dineshannayya/riscduino/docs/source/_static/riscduino_layout.png

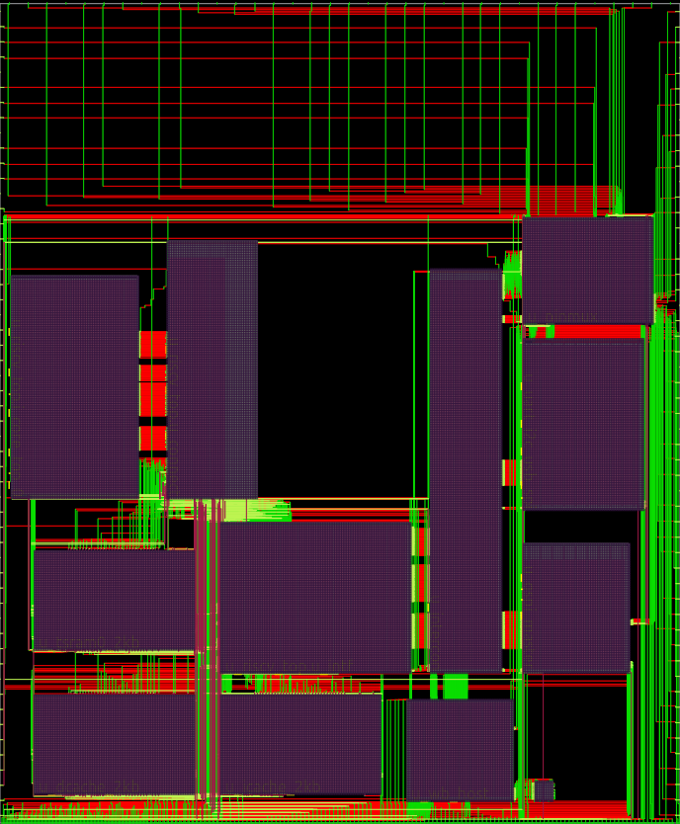
docs/source/_static/riscduino_layout.png
