dineshannayya/riscduino/docs/source/_static/riscduino_placement.png

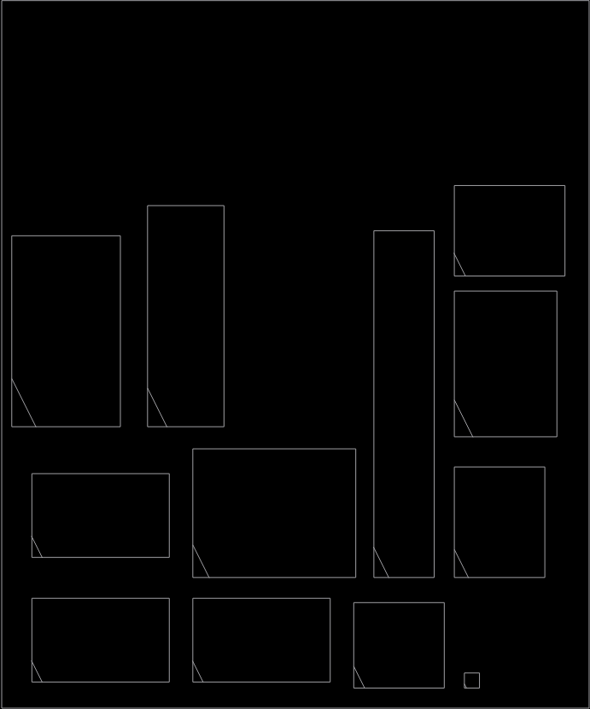
docs/source/_static/riscduino_placement.png
