dineshannayya/riscduino/docs/source/_static/user_project_wrapper.gds.png

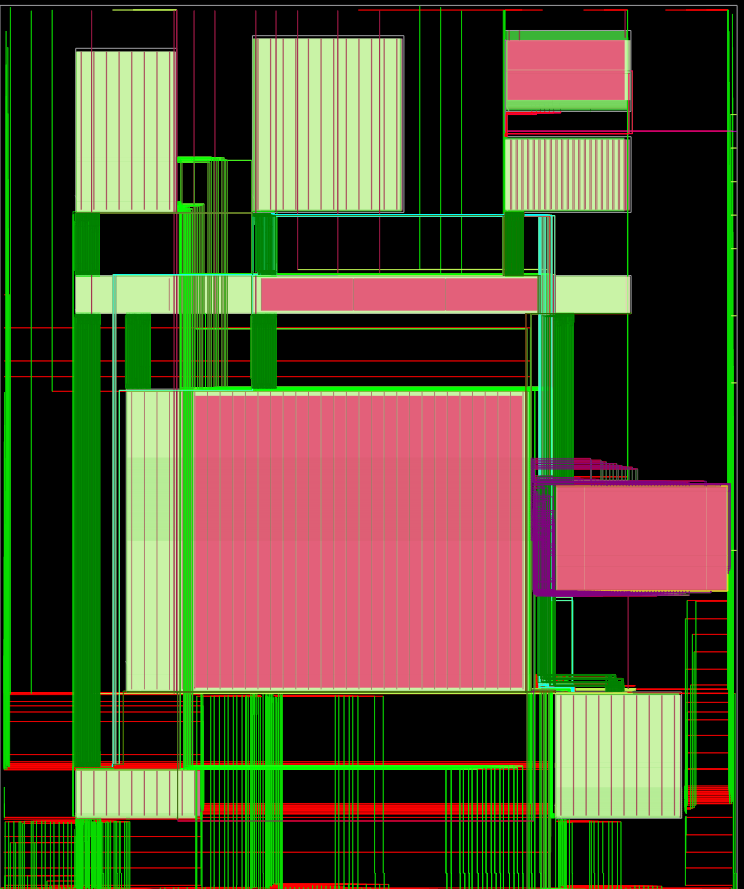
docs/source/_static/user_project_wrapper.gds.png
