dineshannayya/riscduino/signoff/pinmux/final_summary_report.csv

 | design | design_name | config | flow_status | total_runtime | routed_runtime | (Cell/mm^2)/Core_Util | DIEAREA_mm^2 | CellPer_mm^2 | OpenDP_Util | Peak_Memory_Usage_MB | cell_count | tritonRoute_violations | Short_violations | MetSpc_violations | OffGrid_violations | MinHole_violations | Other_violations | Magic_violations | antenna_violations | lvs_total_errors | cvc_total_errors | klayout_violations | wire_length | vias | wns | pl_wns | optimized_wns | fastroute_wns | spef_wns | tns | pl_tns | optimized_tns | fastroute_tns | spef_tns | HPWL | routing_layer1_pct | routing_layer2_pct | routing_layer3_pct | routing_layer4_pct | routing_layer5_pct | routing_layer6_pct | wires_count | wire_bits | public_wires_count | public_wire_bits | memories_count | memory_bits | processes_count | cells_pre_abc | AND | DFF | NAND | NOR | OR | XOR | XNOR | MUX | inputs
0 | /project/openlane/pinmux | pinmux | pinmux | flow completed | 0h17m45s0ms | 0h12m53s0ms | 49486.86868686869 | 0.2475 | 24743.434343434346 | 29.48 | 917.81 | 6124 | 0 | 0 | 0 | 0 | 0 | 0 | 0 | -1 | 0 | -1 | -1 | 483164 | 61636 | -9.79 | -17.46 | -1 | 0.0 | 0.0 | -11345.75 | -19773.69 | -1 | 0.0 | 0.0 | 383662660.0 | 0.0 | 61.73 | 48.44 | 33.8 | 24.46 | -1 | 4054 | 9557 | 810 | 6313 | 0 | 0 | 0 | 4601 | 152 | 83 | 49 | 97 | 1014 | 154 | 18 | 287 | 1210
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
