dineshannayya/riscduino/signoff/qspim_top/final_summary_report.csv

 | design | design_name | config | flow_status | total_runtime | routed_runtime | (Cell/mm^2)/Core_Util | DIEAREA_mm^2 | CellPer_mm^2 | OpenDP_Util | Peak_Memory_Usage_MB | cell_count | tritonRoute_violations | Short_violations | MetSpc_violations | OffGrid_violations | MinHole_violations | Other_violations | Magic_violations | antenna_violations | lvs_total_errors | cvc_total_errors | klayout_violations | wire_length | vias | wns | pl_wns | optimized_wns | fastroute_wns | spef_wns | tns | pl_tns | optimized_tns | fastroute_tns | spef_tns | HPWL | routing_layer1_pct | routing_layer2_pct | routing_layer3_pct | routing_layer4_pct | routing_layer5_pct | routing_layer6_pct | wires_count | wire_bits | public_wires_count | public_wire_bits | memories_count | memory_bits | processes_count | cells_pre_abc | AND | DFF | NAND | NOR | OR | XOR | XNOR | MUX | inputs
0 | /project/openlane/qspim_top | qspim_top | qspim_top | flow completed | 0h19m49s0ms | 0h14m3s0ms | 65696.9696969697 | 0.2475 | 32848.48484848485 | 37.92 | 1031.26 | 8130 | 0 | 0 | 0 | 0 | 0 | 0 | 0 | -1 | 0 | -1 | -1 | 419590 | 71747 | -0.55 | -5.04 | -1 | 0.0 | 0.0 | -21.45 | -1943.78 | -1 | 0.0 | 0.0 | 256460720.0 | 0.0 | 50.47 | 49.05 | 23.05 | 22.36 | -1 | 7374 | 11038 | 803 | 4466 | 0 | 0 | 0 | 8348 | 263 | 96 | 195 | 114 | 1420 | 214 | 34 | 1460 | 1553
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
