dineshannayya/riscduino/signoff/uart_i2cm_usb/final_summary_report.csv

 | design | design_name | config | flow_status | total_runtime | routed_runtime | (Cell/mm^2)/Core_Util | DIEAREA_mm^2 | CellPer_mm^2 | OpenDP_Util | Peak_Memory_Usage_MB | cell_count | tritonRoute_violations | Short_violations | MetSpc_violations | OffGrid_violations | MinHole_violations | Other_violations | Magic_violations | antenna_violations | lvs_total_errors | cvc_total_errors | klayout_violations | wire_length | vias | wns | pl_wns | optimized_wns | fastroute_wns | spef_wns | tns | pl_tns | optimized_tns | fastroute_tns | spef_tns | HPWL | routing_layer1_pct | routing_layer2_pct | routing_layer3_pct | routing_layer4_pct | routing_layer5_pct | routing_layer6_pct | wires_count | wire_bits | public_wires_count | public_wire_bits | memories_count | memory_bits | processes_count | cells_pre_abc | AND | DFF | NAND | NOR | OR | XOR | XNOR | MUX | inputs
0 | /project/openlane/uart_i2cm_usb | uart_i2c_usb_top | uart_i2cm_usb | Flow_completed | 0h25m24s | 0h9m59s | 59157.14285714286 | 0.42 | 29578.57142857143 | 45 | 758.68 | 12423 | 0 | 0 | 0 | 0 | 0 | 0 | 0 | 0 | 0 | -1 | 0 | 522443 | 99881 | -3.16 | -3.16 | -3.07 | -3.07 | -3.11 | -91.08 | -91.08 | -91.67 | -91.67 | -91.56 | 390283627 | 0.0 | 31.24 | 29.46 | 0.31 | -1 | -1 | 12407 | 12476 | 2262 | 2331 | 0 | 0 | 0 | 12423 | 364 | 10 | 202 | 244 | 2118 | 325 | 79 | 2692 | 2224
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
