dineshannayya/riscduino/signoff/spi_master/final_summary_report.csv

 | design | design_name | config | flow_status | total_runtime | routed_runtime | (Cell/mm^2)/Core_Util | DIEAREA_mm^2 | CellPer_mm^2 | OpenDP_Util | Peak_Memory_Usage_MB | cell_count | tritonRoute_violations | Short_violations | MetSpc_violations | OffGrid_violations | MinHole_violations | Other_violations | Magic_violations | antenna_violations | lvs_total_errors | cvc_total_errors | klayout_violations | wire_length | vias | wns | pl_wns | optimized_wns | fastroute_wns | spef_wns | tns | pl_tns | optimized_tns | fastroute_tns | spef_tns | HPWL | routing_layer1_pct | routing_layer2_pct | routing_layer3_pct | routing_layer4_pct | routing_layer5_pct | routing_layer6_pct | wires_count | wire_bits | public_wires_count | public_wire_bits | memories_count | memory_bits | processes_count | cells_pre_abc | AND | DFF | NAND | NOR | OR | XOR | XNOR | MUX | inputs
0 | /project/openlane/spi_master | spim_top | spi_master | Flow_completed | 0h20m39s | 0h10m39s | 58438.46153846153 | 0.26 | 29219.230769230766 | 47 | 664.71 | 7597 | 0 | 0 | 0 | 0 | 0 | 0 | 0 | 0 | 3 | -1 | 0 | 384228 | 67124 | 0.0 | 0.0 | 0.0 | 0.0 | 0.0 | 0.0 | 0.0 | 0.0 | 0.0 | 0.0 | 294776771 | 0.0 | 31.33 | 39.79 | 0.04 | -1 | -1 | 7537 | 7673 | 1268 | 1404 | 0 | 0 | 0 | 7597 | 245 | 0 | 169 | 100 | 1051 | 210 | 32 | 2443 | 1353
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
