dineshannayya/riscduino/(threads)

Thread 4 (2022-02-25):

Openlane implementation error

Sya0, 2022-02-25:
I updated my docker by replacing mpw5 in your docker repo. I got running simulation except spi that fails. However, when I run `make` command in openlane folder or `make user_project_wrapper` in riscdunio root path I got error about some path which I do not have.

```
Error: sta.tcl, 126 can't read "::env(CLOCK_PORT)": no such variable
[ERROR]: during executing: "openroad -exit /openlane/scripts/openroad/resizer.tcl |& tee >&@stdout /project/openlane/clk_skew_adjust/runs/clk_skew_adjust/logs/placement/7-resizer_design_optimization.log"
```

```
Run Directory: /project/openlane/clk_skew_adjust/runs/clk_skew_adjust                                                                                                                                                              
Source not found.

Source: /project/openlane/clk_skew_adjust/runs/clk_skew_adjust/results/lvs/clk_skew_adjust.lvs_parsed.gds.log                                                                                                                      
Source not found.

[INFO]: check full report here: /project/openlane/clk_skew_adjust/runs/clk_skew_adjust/reports/final_summary_report.csv
[INFO]: Saving Runtime Environment
```

There is no path which begins with `project` in my directories. Is there any solution about it ? Thanks for your previous quick replies btw.

dineshannayya, 2022-02-25:
I guess this may be due to openlane docker ..

1.  Can you pull my project openlane docker:    riscduino/openlane:mpw5
> docker pull riscduino/openlane:mpw5

2. set the environmental variable
export IMAGE_NAME=riscduino/openlane:mpw5
export OPENLANE_IMAGE_NAME=riscduino/openlane:mpw5
export OPENLANE_TAG=mpw5

3. Run Make file
>   make user_project_wrapper

Note:  In the latest git version i have moved docker from my name to project name .. i.e now
dineshannayya/dv_setup:mpw5   =>   riscduino/dv_setup:mpw5
dineshannayya/openlane:mpw5   =>   riscduino/openlane:mpw5

I will cross-check if there any specific issue in SPI simulation

dineshannayya, 2022-02-25:
I have cross-check the spi simulation issue, look like one the .hex is not in git repo .. i have update it to git repo ..

You can update the repo .. this should resolve the simulation issue

Sya0, 2022-02-28:
I do not get it. I still get this path error.
`couldn't read file "/home/sukruuzun/caravel_user_project/caravel/openlane/user_project_wrapper_empty/fixed_wrapper_cfgs.tcl": no such file or directory`.

My caravel example project (32 bit counter) openlane synthesis run flawless but this one gives me error about caravel. `fixed_wrapper_cfgs.tcl` script is under `user_project_wrapper`, not `user_project_wrapper_empty`.

dineshannayya, 2022-03-01:
If are using MPW-5 caravel repo .. there is change in fixed_wrapper_cfgs.tcl file location

In MPW-4 :  $::env(CARAVEL_ROOT)/openlane/**user_project_wrapper_empty**/fixed_wrapper_cfgs.tcl
in MPW-5:  $::env(CARAVEL_ROOT)/openlane/**user_project_wrapper**/fixed_wrapper_cfgs.tcl

You need to locally change this file path based on your caravel repo ...

Note: As there is continuous update in caravel repo,  My repo used still uses MPW4 caravel repo.

Sya0, 2022-03-01:
Yes, I use MPW-5 caravel repo. I do not want to make changes in caravel repo. Is there any other way, I made some changes Makefile but it does not work. Should I edit docker image ?

Sya0, 2022-03-01:
I changed them locally, now I have this;
```
FileNotFoundError: [Errno 2] No such file or directory: '/project/openlane/user_project_wrapper/../../lef//qspim.lef'
[ERROR]: during executing: "/openlane/scripts/mergeLef.py -i /project/openlane/user_project_wrapper/runs/user_project_wrapper/tmp/merged_unpadded.lef /project/openlane/user_project_wrapper/../../lef//qspim.lef /project/openlane/user_project_wrapper/../../lef//pinmux.lef /project/openlane/user_project_wrapper/../../lef//wb_interconnect.lef /project/openlane/user_project_wrapper/../../lef//uart_i2cm_usb_spi.lef /project/openlane/user_project_wrapper/../../lef//wb_host.lef /project/openlane/user_project_wrapper/../../lef//yifive.lef /project/openlane/user_project_wrapper/../../lef//DFFRAM.lef -o /project/openlane/user_project_wrapper/runs/user_project_wrapper/tmp/merged_unpadded.lef |& tee >&@stdout"
```

Sorry to bother you but I am new to this, I stuck a lot.

dineshannayya, 2022-03-01:
Default all the lef and gds files are compressed (.gz)  in git repo.

You need to unzip the file in lef and gds folder by using below command
gzip -d *

OR If you using latest repo .. In the use below command in base folder
make unzip

Sya0, 2022-03-01:
I think, I fix the version issue, no more path or version error. However, I have pds error:
```
key "straps" not known in dictionary
[ERROR]: during executing openroad script /openlane/scripts/openroad/pdn.tcl
[ERROR]: Exit code: 1
[ERROR]: Last 10 lines:
child process exited abnormally
```

dineshannayya, 2022-03-01:
Are you using riscduino/openlane:mpw5 OR efabless/openlane  docker ?

I have done PDN hack in Openroad setup to get Power Straps only for vccd1/vssd1. Else in standard Openlane flow does power straps for all the power vccd1/vssd1/vccd2/vssd2/vdda1/vssa1/vdda2/vssa2
This should work with riscduino/openlane:mpw5 docker.

If you want to works with efabless/openlane docker .. Then you can mask below line in user_project_wrapper/Makefile
set ::env(PDN_CFG) $proj_dir/pdn_cfg.tcl

Sya0, 2022-03-01:
Yes, I use efabless/openlane. Is there any possible disadvantage of doing that hack during tape-out?
`Then you can mask below line in user_project_wrapper/Makefile` by meaning that should I comment that line ?

dineshannayya, 2022-03-01:
My Design IP uses only one set of power domain (vccd1/vssd1).  Default openlane flow does power straps for all power domain vccd1/vssd1/vccd2/vssd2/vdda1/vssa1/vdda2/vssa2, even though design need one set of power hook up for hard-macro.
Due to these i need to keep more free space between each hard-macro to get all 8 vertical and horizontal power strip to get connected ..  As my design has less free space between IP.  I have hacked PDN script to excluded un-intended power straps generation, which helps me to keep only 2 vertical and horizontal power strip spacing between hard-ip.

Correction:  You need to comment pdn_cfg.tcl in user_project_wrapper/config.tcl to get openlane flow to working ..
set ::env(PDN_CFG) $proj_dir/pdn_cfg.tcl

If openlane flow PDN connection breaks then you need to move around the macro location to get PDN to pass.

Sya0, 2022-03-01:
I passed lot of checks and synthesis including PDN but now I have this.
```
[ERROR]: during executing: "magic -noconsole -dnull -rcfile /home/sukruuzun/caravel_pdk/sky130A/libs.tech/magic/sky130A.magicrc /openlane/scripts/magic/gds_pointers.tcl </dev/null |& tee >&@stdout /project/openlane/user_project_wrapper/runs/user_project_wrapper/logs/finishing/20-gds_ptrs.log"                                               
[ERROR]: Exit code: 1
[ERROR]: Last 10 lines:
child killed: kill signal
```

dineshannayya, 2022-03-01:
@Sya0 I don't know if this issue related to latest openlane tools. you may need to get help from openlane team.

As you see some of the tool update breaks project .. periodically i check for working openlane docker and clone it to riscdino/openlane

Closed 2022-03-04.

Thread 6 (2022-07-07):

riscduino soc

RanChenRivai, 2022-07-07:
The riscduino is a great project, but after learning about it, I still have some confusion.

Is there a relevant FPGA test routine for the riscduino SOC?
There are some differences between the memory map of riscduino SOC and the memory map of caravel SOC. For example, 0x1000_0000 is QSPI config reg for riscduino and flash spi for caravel, what is the reason for this?

dineshannayya, 2022-07-07:
Q1.: Is there a relevant FPGA test routine for the riscduino SOC?
    Riscduino is currently planned for Efabless MPW 130nm Skywater Free shuttle. Since complete RTL source code is available in the database, any one can port it to FPGA.
 Q2: There are some differences between the memory map of riscduino SOC and the memory map of caravel SOC. For example, 0x1000_0000 is QSPI config reg for riscduino and flash spi for caravel, what is the reason for this?

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

Riscduno has it's own RISC-V processor and it uses QSPI to boot it's processor and has it's own address mapping.
Where as caravel top-level has it's own  RISC-V core which uses SPI to boot and has there own address map.
RISCDUNIO just uses Top-level RISC-V core to just boot the user core and rest of functionality is managed by RISCDUINO core.
Caravel RISC-V core can access the RISCDUNIO core through a indirect address map (As User project address space is allocated is small)

dineshannayya, 2022-07-09:
Closing the issue

Closed 2022-07-09.

Thread 7 (2022-07-08):

MPW-5 single core git version

clp510, 2022-07-08:
How do I get your MPW-5 single core git version?
If i understand correctly, all your MPW code in the same git repo, same branch(master), How do I get different MPW version code? is that possible?

BRs
luping

dineshannayya, 2022-07-08:
Yes, Riscduino has manged through Single Git Repo for all the MPW project.  As there was continuous change in design, I was not clear on which version of the design will be finally picked in the MPW.  To understand the current design version, I have kept two register which indicate the last update and version id inside the pin mux block.  This register will help me to identify version of the chip manufactured.

Due to MPW lottery system , Riscduino-Dcore & Riscduino-QCore are part of MPW-5 shuttle and Riscduino Single core is not part of the MPW-5.
Is any specific reason why you are looking for MPW5 instead of latest version ?

clp510, 2022-07-09:
Thanks for your comments. and thanks for your good project.
Actually I am developing a new riscv core, and I'd like to pick up a stable code base to diverge, to continue the core side develop.
MPW5 is not a *must*, stable is more important for me .
And by the way ,another question is , you say riscduino is pin compatible with Arduino, but Arduino UNO is DIP package format which has only 28 pins, but the open MPW is QFN/WCSP package, It means,  I will draw my own PCB, not buy a arduino UNO , and replace the ATmega328 chip.

dineshannayya, 2022-07-09:
In MPW shuttle has fixed 38 Pin IO with  QFN/WCSP package for user project. I have tried to map 28 Pins as in arduino and rest of the pins are used for External FLASH (As MPW shuttle does have any on-chip FLASH).  You need to make your own PCB and bring the connector as in arudino. If in future if MPW support user defined own package + Internal FLASH, then we can make pin compatible ATMGA chip.
If you planning to branch out, you may need to continuously monitor the changes as currently i am porting ardunio software driver and there will be some design fixes to match the ardunio functionality.

clp510, 2022-07-11:
Thanks to your comments, will follow your advice ~~

dineshannayya, 2022-07-11:
closing the ticket

Closed 2022-07-11.

Thread 8 (2022-07-11):

caravel soc & riscduino soc memory mapping

Yuxiang-Davion, 2022-07-11:
Is the Uart Master in the diagram a new addition to the RISCDUINO core? Seems like it‘s another uart input directly connected to the package pin.
Actually we are planning to build a new project based on the RISCDUINO for open-mpw flow, but we have found that the memory mapping of the caravel soc and the riscduino soc are not the same. What is the basis for this? If we change the memory mapping of riscduino to match the caravel soc, what needs to be changed?

BRs
Yuxiang
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

Yuxiang-Davion, 2022-07-12:
Yeah I see the bug you metioned in caravel SOC... Hope it could be fixed in next mpw project. Thank you for your reply.

Closed 2022-07-12.

Thread 11 (2022-07-22):

openlane/Module call problem

pengpeng-lian, 2022-07-22:
When "make user_project_wrapper",  its config. tcl file does not contain all verilog files,  but only top and its next level. Why can it run all of them?

===================================code==================================
## Source Verilog Files
set ::env(VERILOG_FILES) "\
	$proj_dir/../../verilog/rtl//yifive/ycr1c/src/top/ycr_top_wb.sv \
	$proj_dir/../../verilog/rtl/user_project_wrapper.v"
### Black-box verilog and views

set ::env(VERILOG_FILES_BLACKBOX) "\
        $proj_dir/../../verilog/gl/qspim_top.v \
        $proj_dir/../../verilog/gl/wb_interconnect.v \
        $proj_dir/../../verilog/gl/pinmux.v     \
        $proj_dir/../../verilog/gl/uart_i2c_usb_spi_top.v     \
	$proj_dir/../../verilog/gl/wb_host.v \
	$proj_dir/../../verilog/gl/ycr_intf.v \
	$proj_dir/../../verilog/gl/ycr_core_top.v \
	$proj_dir/../../verilog/gl/ycr_iconnect.v \
	$proj_dir/../../verilog/gl/digital_pll.v \
	$::env(PDK_ROOT)/sky130A/libs.ref/sky130_sram_macros/verilog/sky130_sram_2kbyte_1rw1r_32x512_8.v \
	"
==========================================================================

=================================instruction==================================
make user user_project_wrapper
==========================================================================

pengpeng-lian, 2022-07-22:
Could it be because "set ::env(VERILOG_FILES_BLACKBOX) "\"?   BLACKBOX this parameter?

pengpeng-lian, 2022-07-22:
Could it be because "set ::env(VERILOG_FILES_BLACKBOX) "\"?   BLACKBOX this parameter?

dineshannayya, 2022-07-22:
Each Macro are separately Hardened and Integrated as block box at user_project_wrapper.  If you include all the RTL at user_project_wrapper tool will not be able harden full design in one go.
You need to first run sub macro harden scripts and followed by user_project_wrapper final integration

make pinmux
make uart_i2cm_usb_spi_top
make wb_host  
make ycr_core_top
make ycr_iconnect
make qspim_top
make wb_interconnect
make ycr_intf

make user_project_wrapper

pengpeng-lian, 2022-07-22:
Our team had questions, why separate integrations? Instead of using the total project which contains all the RTL code to integrate at once? Is there a flaw in doing this？

pengpeng-lian, 2022-07-22:
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

 Sorry for the late reply, thank you very much for your answer.
Wouldn't it be more automatic to execute the "make master project" only once?
What is the purpose of this separate integration?

pengpeng-lian, 2022-07-22:
> Current Makefile flow does call automatically all the sub macro. I prefer to run the each macro on need basic to avoid long run time. As most of the time design changes are specific to one macro. For each top-level integration update, you don't need to re-harden all the block.

Thanks for the reply, very useful for me, really appreciate it, solved my problem!

Closed 2022-07-22.

Thread 16 (2022-08-04):

PDN probelm

pengpeng-lian, 2022-08-04:
I have now put all the Verilogs together to run a macro, but have encountered a problem, reporting the following error
#############ERROR###############################
[STEP 6]
[INFO]: Running Tap/Decap Insertion...
[INFO]: Connecting Power: vccd1 & vssd1 to All internal macros.
[INFO]: Generating PDN...
[ERROR]: PDN generation failed.
[ERROR]: You may need to adjust your macro placements or PDN  offsets/pitches to power all standard cell rails (or other PDN stripes)  in your design.
[INFO]: Generating final set of reports...
[INFO]: Created manufacturability report at 'user_project_wrapper/runs/user_project_wrapper/reports/manufacturability.rpt'.
[INFO]: Created metrics report at 'user_project_wrapper/runs/user_project_wrapper/reports/metrics.csv'.
[INFO]: Saving runtime environment...
[ERROR]: Flow failed.

#########################config.tcl###############################################
set ::env(PDK) "sky130A"
set ::env(STD_CELL_LIBRARY) "sky130_fd_sc_hd"

# YOU ARE NOT ALLOWED TO CHANGE ANY VARIABLES DEFINED IN THE FIXED WRAPPER CFGS
source $::env(CARAVEL_ROOT)/openlane/user_project_wrapper/fixed_wrapper_cfgs.tcl

# YOU CAN CHANGE ANY VARIABLES DEFINED IN THE DEFAULT WRAPPER CFGS BY OVERRIDING THEM IN THIS CONFIG.TCL
source $::env(CARAVEL_ROOT)/openlane/user_project_wrapper/default_wrapper_cfgs.tcl

set script_dir [file dirname [file normalize [info script]]]
set proj_dir [file dirname [file normalize [info script]]]

set ::env(ROUTING_CORES) "6"

set ::env(DESIGN_NAME) user_project_wrapper
set verilog_root $proj_dir/../../verilog/

# User Configurations
#
set ::env(DESIGN_IS_CORE) 1
set ::env(FP_PDN_CORE_RING) 1

## Source Verilog Files
set ::env(VERILOG_FILES) "\
	$proj_dir/../../verilog/rtl//yifive/ycr1c/src/top/ycr_top_wb.sv                 \
	$proj_dir/../../verilog/rtl/user_project_wrapper.v                              \
    $script_dir/../../verilog/rtl/clk_skew_adjust/src/clk_skew_adjust.gv \
    $script_dir/../../verilog/rtl/pinmux/src/pinmux.sv     \
    $script_dir/../../verilog/rtl/pinmux/src/pinmux_reg.sv \
    $script_dir/../../verilog/rtl/pinmux/src/gpio_intr.sv  \
    $script_dir/../../verilog/rtl/pinmux/src/pwm.sv        \
    $script_dir/../../verilog/rtl/pinmux/src/timer.sv        \
    $script_dir/../../verilog/rtl/lib/pulse_gen_type1.sv   \
    $script_dir/../../verilog/rtl/lib/pulse_gen_type2.sv   \
    $script_dir/../../verilog/rtl/lib/registers.v          \
    $script_dir/../../verilog/rtl/lib/ctech_cells.sv     \

    $script_dir/../../verilog/rtl/lib/reset_sync.sv      \
    $script_dir/../../verilog/rtl/qspim/src/qspim_top.sv \
    $script_dir/../../verilog/rtl/qspim/src/qspim_if.sv \
    $script_dir/../../verilog/rtl/qspim/src/qspim_regs.sv \
    $script_dir/../../verilog/rtl/qspim/src/qspim_fifo.sv \
    $script_dir/../../verilog/rtl/qspim/src/qspim_clkgen.sv \
    $script_dir/../../verilog/rtl/qspim/src/qspim_ctrl.sv \
    $script_dir/../../verilog/rtl/qspim/src/qspim_rx.sv \
    $script_dir/../../verilog/rtl/qspim/src/qspim_tx.sv	\

    $script_dir/../../verilog/rtl/uart/src/uart_core.sv  \
    $script_dir/../../verilog/rtl/uart/src/uart_cfg.sv   \
    $script_dir/../../verilog/rtl/uart/src/uart_rxfsm.sv \
    $script_dir/../../verilog/rtl/uart/src/uart_txfsm.sv \
    $script_dir/../../verilog/rtl/lib/async_wb.sv   \
    $script_dir/../../verilog/rtl/lib/async_fifo.sv      \
    $script_dir/../../verilog/rtl/lib/async_fifo_th.sv   \
    $script_dir/../../verilog/rtl/lib/double_sync_low.v  \
    $script_dir/../../verilog/rtl/lib/clk_ctl.v          \
    $script_dir/../../verilog/rtl/i2cm/src/core/i2cm_bit_ctrl.v      \
    $script_dir/../../verilog/rtl/i2cm/src/core/i2cm_byte_ctrl.v     \
    $script_dir/../../verilog/rtl/i2cm/src/core/i2cm_top.v           \
    $script_dir/../../verilog/rtl/usb1_host/src/core/usbh_core.sv    \
    $script_dir/../../verilog/rtl/usb1_host/src/core/usbh_crc16.sv   \
    $script_dir/../../verilog/rtl/usb1_host/src/core/usbh_crc5.sv    \
    $script_dir/../../verilog/rtl/usb1_host/src/core/usbh_fifo.sv    \
    $script_dir/../../verilog/rtl/usb1_host/src/core/usbh_sie.sv     \
    $script_dir/../../verilog/rtl/usb1_host/src/phy/usb_fs_phy.v     \
    $script_dir/../../verilog/rtl/usb1_host/src/phy/usb_transceiver.v\
    $script_dir/../../verilog/rtl/usb1_host/src/top/usb1_host.sv     \
    $script_dir/../../verilog/rtl/sspim/src/sspim_top.sv             \
    $script_dir/../../verilog/rtl/sspim/src/sspim_ctl.sv             \
    $script_dir/../../verilog/rtl/sspim/src/sspim_if.sv              \
    $script_dir/../../verilog/rtl/sspim/src/sspim_cfg.sv             \
    $script_dir/../../verilog/rtl/uart_i2c_usb_spi/src/uart_i2c_usb_spi.sv\

    $script_dir/../../verilog/rtl/wb_host/src/wb_host.sv \
    $script_dir/../../verilog/rtl/lib/async_reg_bus.sv   \
    $script_dir/../../verilog/rtl/wb_interconnect/src/wb_arb.sv     \
    $script_dir/../../verilog/rtl/uart2wb/src/uart2wb.sv \
    $script_dir/../../verilog/rtl/uart2wb/src/uart2_core.sv \
    $script_dir/../../verilog/rtl/uart2wb/src/uart_msg_handler.v \

    $script_dir/../../verilog/rtl/lib/sync_wbb.sv                \
    $script_dir/../../verilog/rtl/lib/sync_fifo2.sv                \
    $script_dir/../../verilog/rtl/wb_interconnect/src/wb_slave_port.sv  \
    $script_dir/../../verilog/rtl/wb_interconnect/src/wb_interconnect.sv  \

    $script_dir/../../verilog/rtl/yifive/ycr1c/src/core/pipeline/ycr_pipe_top.sv           \
	$script_dir/../../verilog/rtl/yifive/ycr1c/src/core/ycr_core_top.sv                    \
	$script_dir/../../verilog/rtl/yifive/ycr1c/src/core/ycr_dm.sv                          \
	$script_dir/../../verilog/rtl/yifive/ycr1c/src/core/ycr_tapc_synchronizer.sv           \
	$script_dir/../../verilog/rtl/yifive/ycr1c/src/core/ycr_clk_ctrl.sv                    \
	$script_dir/../../verilog/rtl/yifive/ycr1c/src/core/ycr_scu.sv                         \
	$script_dir/../../verilog/rtl/yifive/ycr1c/src/core/ycr_tapc.sv                        \
	$script_dir/../../verilog/rtl/yifive/ycr1c/src/core/ycr_tapc_shift_reg.sv              \
	$script_dir/../../verilog/rtl/yifive/ycr1c/src/core/ycr_dmi.sv                         \
	$script_dir/../../verilog/rtl/yifive/ycr1c/src/core/primitives/ycr_reset_cells.sv      \
	$script_dir/../../verilog/rtl/yifive/ycr1c/src/core/pipeline/ycr_pipe_ifu.sv           \
	$script_dir/../../verilog/rtl/yifive/ycr1c/src/core/pipeline/ycr_pipe_idu.sv           \
	$script_dir/../../verilog/rtl/yifive/ycr1c/src/core/pipeline/ycr_pipe_exu.sv           \
	$script_dir/../../verilog/rtl/yifive/ycr1c/src/core/pipeline/ycr_pipe_mprf.sv          \
	$script_dir/../../verilog/rtl/yifive/ycr1c/src/core/pipeline/ycr_pipe_csr.sv           \
	$script_dir/../../verilog/rtl/yifive/ycr1c/src/core/pipeline/ycr_pipe_ialu.sv          \
	$script_dir/../../verilog/rtl/yifive/ycr1c/src/core/pipeline/ycr_pipe_mul.sv           \
	$script_dir/../../verilog/rtl/yifive/ycr1c/src/core/pipeline/ycr_pipe_div.sv           \
	$script_dir/../../verilog/rtl/yifive/ycr1c/src/core/pipeline/ycr_pipe_lsu.sv           \
	$script_dir/../../verilog/rtl/yifive/ycr1c/src/core/pipeline/ycr_pipe_hdu.sv           \
	$script_dir/../../verilog/rtl/yifive/ycr1c/src/core/pipeline/ycr_pipe_tdu.sv           \
	$script_dir/../../verilog/rtl/yifive/ycr1c/src/core/pipeline/ycr_ipic.sv               \
        $script_dir/../../verilog/rtl/yifive/ycr1c/src/top/ycr_req_retiming.sv               \

    $script_dir/../../verilog/rtl/yifive/ycr1c/src/top/ycr_iconnect.sv                  \
	$script_dir/../../verilog/rtl/yifive/ycr1c/src/top/ycr_cross_bar.sv                 \
	$script_dir/../../verilog/rtl/yifive/ycr1c/src/top/ycr_router.sv                    \
	$script_dir/../../verilog/rtl/yifive/ycr1c/src/top/ycr_dmem_router.sv                \
	$script_dir/../../verilog/rtl/yifive/ycr1c/src/top/ycr_sram_mux.sv                   \
	$script_dir/../../verilog/rtl/yifive/ycr1c/src/top/ycr_tcm.sv                        \
	$script_dir/../../verilog/rtl/yifive/ycr1c/src/top/ycr_timer.sv                      \
        $script_dir/../../verilog/rtl/yifive/ycr1c/src/lib/ycr_arb.sv                     \

        $script_dir/../../verilog/rtl/yifive/ycr1c/src/cache/src/core/dcache_top.sv            \
        $script_dir/../../verilog/rtl/yifive/ycr1c/src/cache/src/core/dcache_tag_fifo.sv       \
        $script_dir/../../verilog/rtl/yifive/ycr1c/src/cache/src/core/icache_tag_fifo.sv       \
        $script_dir/../../verilog/rtl/yifive/ycr1c/src/cache/src/core/icache_top.sv            \
        $script_dir/../../verilog/rtl/yifive/ycr1c/src/cache/src/core/icache_app_fsm.sv        \
        $script_dir/../../verilog/rtl/yifive/ycr1c/src/lib/ycr_async_wbb.sv                    \
	$script_dir/../../verilog/rtl/yifive/ycr1c/src/top/ycr_dmem_wb.sv                      \
	$script_dir/../../verilog/rtl/yifive/ycr1c/src/top/ycr_intf.sv                        \
    $script_dir/../../verilog/rtl/digital_pll/src/digital_pll_controller.v  \
    $script_dir/../../verilog/rtl/digital_pll/src/digital_pll.v             \
    $script_dir/../../verilog/rtl/digital_pll/src/ring_osc2x13.v    \
    "

### Black-box verilog and views
set ::env(VERILOG_FILES_BLACKBOX) "\
    $::env(PDK_ROOT)/sky130A/libs.ref/sky130_sram_macros/verilog/sky130_sram_2kbyte_1rw1r_32x512_8.v	\
    "

set ::env(EXTRA_LEFS) "\
	$::env(PDK_ROOT)/sky130A/libs.ref/sky130_sram_macros/lef/sky130_sram_2kbyte_1rw1r_32x512_8.lef \
	"
set ::env(EXTRA_GDS_FILES) "\
	$::env(PDK_ROOT)/sky130A/libs.ref/sky130_sram_macros/gds/sky130_sram_2kbyte_1rw1r_32x512_8.gds \
	"

## Clock configurations
set ::env(CLOCK_PORT) "user_clock2 wb_clk_i"
set ::env(CLOCK_PERIOD) "10"

set ::env(SYNTH_MAX_FANOUT) 4

## CTS BUFFER
set ::env(CTS_CLK_BUFFER_LIST) "sky130_fd_sc_hd__clkbuf_4 sky130_fd_sc_hd__clkbuf_8 sky130_fd_sc_hd__clkbuf_16 "
set ::env(CTS_SINK_CLUSTERING_SIZE) "\
    16  \
    50  \
    "
set ::env(CLOCK_BUFFER_FANOUT) "\
    8   \
    20  \
    "
set ::env(LEC_ENABLE) 0

set ::env(VERILOG_INCLUDE_DIRS) "\
    [glob $script_dir/../../verilog/rtl/yifive/ycr1c/src/includes ] \
    [glob $script_dir/../../verilog/rtl/i2cm/src/includes $script_dir/../../verilog/rtl/usb1_host/src/includes ]    \
    [glob $script_dir/../../verilog/rtl/yifive/ycr1c/src/includes ] \
    [glob $script_dir/../../verilog/rtl/yifive/ycr1c/src/includes ] \
    [glob $proj_dir/../../verilog/rtl/yifive/ycr1c/src/includes ]
    "
set ::env(SYNTH_READ_BLACKBOX_LIB) 1
set ::env(SYNTH_DEFINES) [list SYNTHESIS ]

set ::env(SDC_FILE) "\
    $script_dir/base.sdc    \
    $script_dir/pinmux.sdc  \
    $script_dir/qspim.sdc   \
    $script_dir/uart_i2cm_usb_spi_top.sdc   \
    $script_dir/wb_host.sdc \
    $script_dir/wb_interconnect.sdc \
    $script_dir/ycr_core_top.sdc    \
    $script_dir/ycr_iconnect.sdc    \
    $script_dir/ycr_intf.sdc    \
    "
set ::env(BASE_SDC_FILE) "$script_dir/base.sdc"

set ::env(VDD_PIN) [list {vccd1}]
set ::env(GND_PIN) [list {vssd1}]

set ::env(VDD_NETS) {vccd1 vccd2 vdda1 vdda2}
set ::env(GND_NETS) {vssd1 vssd2 vssa1 vssa2}

## Floorplan
set ::env(FP_PIN_ORDER_CFG) $script_dir/pin_order.cfg
set ::env(FP_SZING) absolute

set ::env(MACRO_PLACEMENT_CFG) $script_dir/macro.cfg
set ::env(PL_TARGET_DENSITY) 0.4
set ::env(PDN_CFG) $proj_dir/pdn_cfg.tcl

set ::env(RT_MAX_LAYER) {met5}

set ::env(FP_PDN_CHECK_NODES) 0

set ::env(GLB_RT_MAX_DIODE_INS_ITERS) 10
set ::env(DIODE_INSERTION_STRATEGY) 3

set ::env(QUIT_ON_TIMING_VIOLATIONS) "0"
set ::env(QUIT_ON_MAGIC_DRC) "1"
set ::env(QUIT_ON_LVS_ERROR) "1"
set ::env(QUIT_ON_SLEW_VIOLATIONS) "0"

#Need to cross-check why global timing opimization creating setup vio with hugh hold fix
set ::env(GLB_RESIZER_TIMING_OPTIMIZATIONS) "0"

#
set ::env(RUN_CVC) 0

#
set ::env(PL_RESIZER_DESIGN_OPTIMIZATIONS) 1
set ::env(PL_RESIZER_TIMING_OPTIMIZATIONS) 0

### Macro PDN Connections
set ::env(FP_PDN_ENABLE_GLOBAL_CONNECTIONS) "1"

set ::env(GLB_RT_OBS) "                              \
	                li1   150 130  833.1  546.54,\
	                met1  150 130  833.1  546.54,\
	                met2  150 130  833.1  546.54,\
                        met3  150 130  833.1  546.54,\
	                li1   950 130  1633.1 546.54,\
	                met1  950 130  1633.1 546.54,\
	                met2  950 130  1633.1 546.54,\
                        met3  950 130  1633.1 546.54,\
                        li1   150  750 833.1  1166.54,\
                        met1  150  750 833.1  1166.54,\
                        met2  150  750 833.1  1166.54,\
                        met3  150  750 833.1  1166.54,\
	                met5  0 0 2920 3520"

set ::env(FP_PDN_POWER_STRAPS) "vccd1 vssd1 1, vccd2 vssd2 0, vdda1 vssa1 0, vdda2 vssa2 0"

###PDN offset and pitch
set ::env(FP_IO_VEXTEND) 4
set ::env(FP_IO_HEXTEND) 4

set ::env(FP_PDN_VPITCH) 100
set ::env(FP_PDN_HPITCH) 100
set ::env(FP_PDN_VWIDTH) 5
set ::env(FP_PDN_HWIDTH) 5

set ::env(FP_PDN_VOFFSET) "5"
set ::env(FP_PDN_HOFFSET) "10"

set ::env(FP_PDN_HORIZONTAL_HALO) "10"
set ::env(FP_PDN_VERTICAL_HALO) "10"

set ::env(FP_PDN_VSPACING) "15.5"
set ::env(FP_PDN_HSPACING) "10"

pengpeng-lian, 2022-08-04:
##########################Supplementary macro.cfg###########################
u_dcache_2kb                150             130            N
u_icache_2kb                950             130            N
u_tsram0_2kb                150             750            N

pengpeng-lian, 2022-08-04:
I checked the def and found the cells overlapped!

dineshannayya, 2022-08-04:
I am not tried flat design in openlane flow.  You need to raise issue in openroad/openlane forum.

Closed 2022-08-05.

Thread 19 (2022-08-22):

Problems with ‘make user_project_wrapper'

pengpeng-lian, 2022-08-22:
####################error#######################################
OpenLane UNKNOWN
(with mounted scripts from couldn't create error file for command: **permission denied**)
All rights reserved. (c) 2020-2022 Efabless Corporation and contributors.
Available under the Apache License, version 2.0. See the LICENSE file for more details.

couldn't create error file for command: **permission denied**

dineshannayya, 2022-08-23:
No clarity on how you are running this repo and where ..

Closed 2022-08-23.

Thread 21 (2022-09-05):

How can I program the RISCDUINO SOC?

Aman-ECE, 2022-09-05:
I saw this RISCDUINO SoC project on the efabless website and it blew up my mind so interestingly I landed upon your GitHub page. I have a set of questions in my mind which are as follows:

Q.1: Have you received and tested the RISCDUINO?
Q.2: How can I burn the program in RISCDUINO?
Q.3: What are the tools (compilers, IDE, etc) required to build the firmware? I've seen that you are working on integration with Arduino IDE but also fails to find any solution for windows. is there any other possible way to carry on the development with windows?

dineshannayya, 2022-09-05:
Q.1: Have you received and tested the RISCDUINO?
<Ans> RISCDUINO project successfully got a tape-out slot efabless in
MPW-3/MPW-4/MPW-5/MPW-6 Shuttle. Even though tape-out was done long back,
still efabless yet to deliver MPW-2 chip's itself. Only chip tape-out date
hanpening as per schedule, not the chip delivery.  So I have not yet
received my first version of RISCDUINO MPW-3 chip.
Currently I am refreshing my 5th version of RISCDUINO in MPW-7 which has
most of the Arduino Digital functionality.

Q.2: How can I burn the program in RISCDUINO?
<Ans> We have three ways to Burn the RISCDUINO,
       A. Using UART I/F as in Arduino upload function
       B.  Using SPI ISP function as in Arduino
       C.  Caravel has extra RISCV core, which can be used for flash
programming.
Q.3: What are the tools (compilers, IDE, etc) required to build the
firmware? I've seen that you are working on integration with Arduino IDE
but also fail to find any solution for windows. Is there any other possible
way to carry on the development with windows?
<Ans> We need RISCV tool set and these will be part of RISCDUINO board
plug-in. For User it will look like one more type of arduino board and need
to just link the board driver
https://github.com/dineshannayya/riscduino_board/
in the arduino-ide tool.  I have tested it from arudino-ide 11 version. I
expect it will be be transparent for windows/unix. But I have still
validated it in the unix/ubuntu version only.
I have ported and validated following arudino example in Riscduino
environment

   1.
   https://github.com/dineshannayya/riscduino/blob/master/verilog/dv/arduino_arrays/arduino_arrays.ino
   2.
   https://github.com/dineshannayya/riscduino/blob/master/verilog/dv/arduino_ascii_table/arduino_ascii_table.ino
   3.
   https://github.com/dineshannayya/riscduino/blob/master/verilog/dv/arduino_digital_port_control/arduino_digital_port_control.ino
   4.
   https://github.com/dineshannayya/riscduino/blob/master/verilog/dv/arduino_gpio_intr/arduino_gpio_intr.ino
   5.
   https://github.com/dineshannayya/riscduino/blob/master/verilog/dv/arduino_hello_world/arduino_hello_world.ino
   6.
   https://github.com/dineshannayya/riscduino/blob/master/verilog/dv/arduino_i2c_scaner/arduino_i2c_scaner.ino
   7.
   https://github.com/dineshannayya/riscduino/blob/master/verilog/dv/arduino_i2c_wr_rd/arduino_i2c_wr_rd.ino
   8.
   https://github.com/dineshannayya/riscduino/blob/master/verilog/dv/arduino_multi_serial/arduino_multi_serial.ino
   9.
   https://github.com/dineshannayya/riscduino/blob/master/verilog/dv/arduino_risc_boot/arduino_risc_boot.ino
   10.
   https://github.com/dineshannayya/riscduino/blob/master/verilog/dv/arduino_string/arduino_string.ino
   11.
   https://github.com/dineshannayya/riscduino/blob/master/verilog/dv/arduino_switchCase2/arduino_switchCase2.ino
   12.
   https://github.com/dineshannayya/riscduino/blob/master/verilog/dv/arduino_timer_intr/arduino_timer_intr.ino
   13.
   https://github.com/dineshannayya/riscduino/blob/master/verilog/dv/arduino_ws281x/arduino_ws281x.ino

I expect it will take at least one more year to get a working project.

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

Aman-ECE, 2022-09-07:
Thank you so much for the detailed answers and going forward with my interest in RISCDUINO,

Q.1 As your GitHub page (https://github.com/dineshannayya/riscduino_board/) says that the installation of RISCDUINO boards is supported for macOS and Linux. Along with the porting and validation of Arduino examples in the RISCDUINO environment, do you also working on making compatible the RISCDUINO boards for windows too? Currently, I am getting the following message in the Arduino IDE (v2.0 RC) when I tried it with windows.

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

Q.2 How are you testing and working on further developments? Had you gotten the RISCDUINO fabricated from some other services/company/programs other than efabless? or are you testing with some sort of simulation-based approach? In short, I am very much interested to see the RISCDUINO working in the real world so do you have this chip in your hands yet from any other source?

Aman-ECE, 2022-09-26:
>

Hi

Waiting for your response...

dineshannayya, 2022-10-01:
@Aman-ECE Sorry busy with other technical work.

A1. currently I have verified only in Ubuntu, I have moved this issue as bug. you can also contribute fix this issue as it's need Arduino board integration methodology.
A2. I have not yet tried this design other than efabless MPW shuttle. Design has been validated with around 100+ RTL simulation.  For bring-up, we can use the Arduino board itself with just replacing ATMGA chip with this one.

dineshannayya, 2023-07-19:
I have integrated it to windows version now.

Aman-ECE, 2023-07-19:
Thanks for the update!!

Closed 2023-07-19.

Thread 23 (2023-01-10):

Document ADC Shortcomings

xobs, 2023-01-10:
The block diagram on the front page lists a 6-channel ADC as being one of the features, and there are RTL files that appear to implement a SAR-ADC. However, there are multiple places that state that the ADC is "In progress - looking for community help".

What is the state of this block? Is it waiting for characterization? Is it not included in any files? Or is it included and the documentation just needs to be updated?

dineshannayya, 2023-01-10:
Still this feature is not integrated into this project and looking for community help here. Currently i have tried to integrated partial version for 4x 8Bit DAC.

Thread 26 (2023-08-22):

linting issue

shanu101, 2023-08-22:
[linter.log](https://github.com/dineshannayya/riscduino/files/12407236/linter.log)
hello sir , i was runnig rtl to gds flow using openlane , but in am getting linter issue , could you please help me  to take care of it .

dineshannayya, 2023-08-22:
attach run log to understand the issue

Thread 27 (2023-09-18):

Where to buy a riscduino board?

redpanda3, 2023-09-18:
Hi, I would like to buy a riscduino sample board. Where can I get it?

dineshannayya, 2023-09-18:
You can contact VSD team:  vsd@vlsisystemdesign.com, they may have option to buy Riscduino Development board.

redpanda3, 2023-09-18:
Thank you.

Closed 2023-09-18.

Thread 28 (2023-11-16):

Discrepencies in the readme.

govardhnn, 2023-11-16:
In the SOC Pin Mapping Section of the README, the diagram and table values do not match.

ATMEGA328 Pin No 1 in the diagram is connected to Arduino Digital Pin 22 (D22) but in the the Table right below it, its D20.

Similiarly, there is mismatches at PINS 9 and 10.

Upon closer observation, one can notice that these are only for Arduino functions (reset and crystal) which aren't defined by specification. [ATmega168/328P-Arduino Pin Mapping](https://docs.arduino.cc/hacking/hardware/PinMapping168)

Can you please clarify which of these is the correct pin mapping?

Closed 2023-12-20.

Thread 29 (2024-02-02):

Error while running riscv_regress test

Ajay-2204, 2024-02-02:
Hello,
I am running riscv_regress test using make verify-riscv_regress command.
I am getting error as below,

1.
In C-ANDI.S file, It showing illegal operands error in line number 50, 63, 76, 89 and 102. (i.e., TEST_CI_OP(c.andi, x11, 0x0, 0x0, 0x0, x2, 0), TEST_CI_OP(c.addi, x12, 0x2, 0x1, 0x1, x2, 0), TEST_CI_OP(c.addi, x17, 0, -0x1, 0x1, x2, 0), TEST_CI_OP(c.addi, x22, 0x80000, 0x7ffff, 0x1, x2, 0), TEST_CI_OP(c.addi, x27, 0x80001, 0x80000, 0x1, x2, 0)

Even in riscduino/verilog/dv/riscv_regress/dependencies/riscv-tests/isa/rv64si/csr.s file, for the instruction csrwi it is showing **Instruction csrwi requires absolute expression **.

2.
Compiling ../../../common/vpi/system/system.c...
../../../common/vpi/system/system.c: In function 'system_compiletf':
../../../common/vpi/system/system.c:4:34: warning: unused parameter 'user_data' [-Wunused-parameter]
    4 | static int system_compiletf(char*user_data)
      |                             ~~~~~^~~~~~~~~
../../../common/vpi/system/system.c: In function 'system_calltf':
../../../common/vpi/system/system.c:33:7: warning: implicit declaration of function 'system' [-Wimplicit-function-declaration]
   33 |       system(value_s.value.str);
      |       ^~~~~~
../../../common/vpi/system/system.c: At top level:
../../../common/vpi/system/system.c:37:6: warning: function declaration isn't a prototype [-Wstrict-prototypes]
   37 | void system_register()
      |      ^~~~~~~~~~~~~~~
../../../common/vpi/system/system.c:50:1: warning: function declaration isn't a prototype [-Wstrict-prototypes]
   50 | void (*vlog_startup_routines[])() = {
      | ^~~~
Making system.vpi from  system.o...
/bin/sh: 9: 	: not found
make: *** [Makefile:280: run_iverilog] Error 127
make: *** [Makefile:130: verify-riscv_regress] Error 2

Please help me out to run this test successfully.

dineshannayya, 2024-07-14:
I have done clean-up on the flow, you can re pull and try one more time.

Thread 31 (2024-07-14):

Iverilog Version

redpanda3, 2024-07-14:
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 Hi Dinesh, I have a problem when verifying the user_usb, the iverilog I'm using gives me a warning like this, could you tell me which iverilog you are using?

redpanda3, 2024-07-14:
mine is 11.

dineshannayya, 2024-07-14:
These are warning, simulation still will work.

redpanda3, 2024-07-14:
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
Could you please take a look at it here? I see no waveform generated.

dineshannayya, 2024-07-14:
I don't see Error details, Mostly if will be at starting of the log

redpanda3, 2024-07-14:
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
Yes, you are correct. Seems that problem came from AES module, I will take a look at that. Thank you.

dineshannayya, 2024-07-14:
Looks like there are lint issues due to the latest iverilog, I have pushed
fixes back to repo .. You can pull the changes and sub-git repos.

On Sun, Jul 14, 2024 at 11:35 AM Painting(Looking for jobs or Phd
positions) ***@***.***> wrote:

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

redpanda3, 2024-07-14:
Thank you.

redpanda3, 2024-07-14:
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
In the security_core provided in the submodule, the version might not be the latest(has no idle signal).  After git pull the latest and manually upgrade the security_core, dv now works. Thank you.

Thread 32 (2024-07-22):

ctech_clk_buf in aes_top

redpanda3, 2024-07-22:
Hi, Dinesh,

During the verification in caravel_hkspi, there might be an inconsistency between the ctech_clk_buf in aes_top and ctech_clk_buf itself.

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

One solution is to reduce the power pins in ctech_clk_buf, another is to change the signal ports in aes_top or don't set USE_POWER_PINS in settings. I don't know which solution is adequate. So I submit an issue here.

Best,
Yuda

Thread 33 (2024-11-12):

Running Riscduino in Openlane

Parthatgit, 2024-11-12:
Hello Dinesh sir,
I am trying to run the Riscduino soc using  openlane toolflow, but it seems that I keep running into problems with on step 4, where the flow uses tries to use pin_order.cfg file, but after trying multipl variations in the format and value in this file, it keeps giving me the same error that I will attach below.
Additionally on designs like DFFRAM, where I made my own config.json and .sdc file, it runs into some problem on step 26, detailed routing, for some reason the flow gets killed. It can't be due to storage, as I have tried it on a setup with 1TB memory.
Can you suggest any changes that we need to make in the designs to make it openlane compatible or point me to an updated resource. I have already used Openlane documentation as a reference.
Thanks

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
