dineshannayya/riscduino/verilog/dv/user_aes/user_aes.c

//////////////////////////////////////////////////////////////////////////////
// SPDX-FileCopyrightText: 2021, Dinesh Annayya
// 
// Licensed under the Apache License, Version 2.0 (the "License");
// you may not use this file except in compliance with the License.
// You may obtain a copy of the License at
//
//      http://www.apache.org/licenses/LICENSE-2.0
//
// Unless required by applicable law or agreed to in writing, software
// distributed under the License is distributed on an "AS IS" BASIS,
// WITHOUT WARRANTIES OR CONDITIONS OF ANY KIND, either express or implied.
// See the License for the specific language governing permissions and
// limitations under the License.
// SPDX-License-Identifier: Apache-2.0
// SPDX-FileContributor: Dinesh Annayya <dinesha@opencores.org>
// //////////////////////////////////////////////////////////////////////////
#define SC_SIM_OUTPORT (0xf0000000)


#include <stdio.h>
#include <string.h>
#include <stdint.h>

// Enable ECB, CTR and CBC mode. Note this can be done before including aes.h or at compile-time.
// E.g. with GCC by using the -D flag: gcc -c aes.c -DCBC=0 -DCTR=1 -DECB=1
#define CBC 1
#define CTR 1
#define ECB 1

#include "aes.h"


static void phex(uint8_t* str);
static int test_encrypt_cbc(void);
static int test_decrypt_cbc(void);
static int test_encrypt_ctr(void);
static int test_decrypt_ctr(void);
static int test_encrypt_ecb(void);
static int test_decrypt_ecb(void);
static void test_encrypt_ecb_verbose(void);

#define reg_mprj_globl_reg0  (*(volatile uint32_t*)0x10020000)
#define reg_mprj_globl_reg1  (*(volatile uint32_t*)0x10020004)
#define reg_mprj_globl_reg2  (*(volatile uint32_t*)0x10020008)
#define reg_mprj_globl_reg3  (*(volatile uint32_t*)0x1002000C)
#define reg_mprj_globl_reg4  (*(volatile uint32_t*)0x10020010)
#define reg_mprj_globl_reg5  (*(volatile uint32_t*)0x10020014)
#define reg_mprj_globl_reg6  (*(volatile uint32_t*)0x10020018)
#define reg_mprj_globl_reg7  (*(volatile uint32_t*)0x1002001C)
#define reg_mprj_globl_reg8  (*(volatile uint32_t*)0x10020020)
#define reg_mprj_globl_reg9  (*(volatile uint32_t*)0x10020024)
#define reg_mprj_globl_reg10 (*(volatile uint32_t*)0x10020028)
#define reg_mprj_globl_reg11 (*(volatile uint32_t*)0x1002002C)
#define reg_mprj_globl_reg12 (*(volatile uint32_t*)0x10020030)
#define reg_mprj_globl_reg13 (*(volatile uint32_t*)0x10020034)
#define reg_mprj_globl_reg14 (*(volatile uint32_t*)0x10020038)
#define reg_mprj_globl_reg15 (*(volatile uint32_t*)0x1002003C)
#define reg_mprj_globl_reg16 (*(volatile uint32_t*)0x10020040)
#define reg_mprj_globl_reg17 (*(volatile uint32_t*)0x10020044)
#define reg_mprj_globl_reg18 (*(volatile uint32_t*)0x10020048)
#define reg_mprj_globl_reg19 (*(volatile uint32_t*)0x1002004C)
#define reg_mprj_globl_reg20 (*(volatile uint32_t*)0x10020050)
#define reg_mprj_globl_reg21 (*(volatile uint32_t*)0x10020054)
#define reg_mprj_globl_reg22 (*(volatile uint32_t*)0x10020058)
#define reg_mprj_globl_reg23 (*(volatile uint32_t*)0x1002005C)
#define reg_mprj_globl_reg24 (*(volatile uint32_t*)0x10020060)
#define reg_mprj_globl_reg25 (*(volatile uint32_t*)0x10020064)
#define reg_mprj_globl_reg26 (*(volatile uint32_t*)0x10020068)
#define reg_mprj_globl_reg27 (*(volatile uint32_t*)0x1002006C)

#define reg_mprg_pinmux_gpio_odata (*(volatile uint32_t*)0x10020018)

int main(void)
{
    int exit;

#if defined(AES256)
    //printf("\nTesting AES256\n\n");
#elif defined(AES192)
    //printf("\nTesting AES192\n\n");
#elif defined(AES128)
    //printf("\nTesting AES128\n\n");
#else
    //printf("You need to specify a symbol between AES128, AES192 or AES256. Exiting");
    return 0;
#endif

    reg_mprg_pinmux_gpio_odata  = 0x00000100; 
    reg_mprj_globl_reg23  = 0x00000000; 
    exit = test_encrypt_cbc();
    reg_mprg_pinmux_gpio_odata  = 0x00000200; 
    reg_mprj_globl_reg23  = exit;
    exit += test_decrypt_cbc();
    reg_mprg_pinmux_gpio_odata  = 0x00000300; 
    reg_mprj_globl_reg23  = exit;
    exit += test_encrypt_ctr();
    reg_mprg_pinmux_gpio_odata  = 0x00000400; 
    reg_mprj_globl_reg23  = exit;
    exit += test_decrypt_ctr();
    reg_mprg_pinmux_gpio_odata  = 0x00000500; 
    reg_mprj_globl_reg23  = exit;
    exit += test_decrypt_ecb();
    reg_mprg_pinmux_gpio_odata  = 0x00000600; 
    reg_mprj_globl_reg23  = exit;
    exit += test_encrypt_ecb();
    reg_mprg_pinmux_gpio_odata  = 0x00000700; 
    reg_mprj_globl_reg23  = exit;
    test_encrypt_ecb_verbose();
    reg_mprg_pinmux_gpio_odata  = 0x00000800; 
    reg_mprj_globl_reg23  = exit;

    if(exit == 0) {
        reg_mprg_pinmux_gpio_odata  = 0x00001800; 
    } else {
        reg_mprg_pinmux_gpio_odata  = 0x0000A800; 
    }

    return exit;
}


// prints string as hex
static void phex(uint8_t* str)
{

#if defined(AES256)
    uint8_t len = 32;
#elif defined(AES192)
    uint8_t len = 24;
#elif defined(AES128)
    uint8_t len = 16;
#endif

    unsigned char i;
    //for (i = 0; i < len; ++i)
    //    printf("%.2x", str[i]);
    //printf("\n");
}

static void test_encrypt_ecb_verbose(void)
{
    // Example of more verbose verification

    uint8_t i;

    // 128bit key
    uint8_t key[16] =        { (uint8_t) 0x2b, (uint8_t) 0x7e, (uint8_t) 0x15, (uint8_t) 0x16, (uint8_t) 0x28, (uint8_t) 0xae, (uint8_t) 0xd2, (uint8_t) 0xa6, (uint8_t) 0xab, (uint8_t) 0xf7, (uint8_t) 0x15, (uint8_t) 0x88, (uint8_t) 0x09, (uint8_t) 0xcf, (uint8_t) 0x4f, (uint8_t) 0x3c };
    // 512bit text
    uint8_t plain_text[64] = { (uint8_t) 0x6b, (uint8_t) 0xc1, (uint8_t) 0xbe, (uint8_t) 0xe2, (uint8_t) 0x2e, (uint8_t) 0x40, (uint8_t) 0x9f, (uint8_t) 0x96, (uint8_t) 0xe9, (uint8_t) 0x3d, (uint8_t) 0x7e, (uint8_t) 0x11, (uint8_t) 0x73, (uint8_t) 0x93, (uint8_t) 0x17, (uint8_t) 0x2a,
                               (uint8_t) 0xae, (uint8_t) 0x2d, (uint8_t) 0x8a, (uint8_t) 0x57, (uint8_t) 0x1e, (uint8_t) 0x03, (uint8_t) 0xac, (uint8_t) 0x9c, (uint8_t) 0x9e, (uint8_t) 0xb7, (uint8_t) 0x6f, (uint8_t) 0xac, (uint8_t) 0x45, (uint8_t) 0xaf, (uint8_t) 0x8e, (uint8_t) 0x51,
                               (uint8_t) 0x30, (uint8_t) 0xc8, (uint8_t) 0x1c, (uint8_t) 0x46, (uint8_t) 0xa3, (uint8_t) 0x5c, (uint8_t) 0xe4, (uint8_t) 0x11, (uint8_t) 0xe5, (uint8_t) 0xfb, (uint8_t) 0xc1, (uint8_t) 0x19, (uint8_t) 0x1a, (uint8_t) 0x0a, (uint8_t) 0x52, (uint8_t) 0xef,
                               (uint8_t) 0xf6, (uint8_t) 0x9f, (uint8_t) 0x24, (uint8_t) 0x45, (uint8_t) 0xdf, (uint8_t) 0x4f, (uint8_t) 0x9b, (uint8_t) 0x17, (uint8_t) 0xad, (uint8_t) 0x2b, (uint8_t) 0x41, (uint8_t) 0x7b, (uint8_t) 0xe6, (uint8_t) 0x6c, (uint8_t) 0x37, (uint8_t) 0x10 };

    // print text to encrypt, key and IV
    //printf("ECB encrypt verbose:\n\n");
    //printf("plain text:\n");
    for (i = (uint8_t) 0; i < (uint8_t) 4; ++i)
    {
        phex(plain_text + i * (uint8_t) 16);
    }
    //printf("\n");

    //printf("key:\n");
    phex(key);
    //printf("\n");

    // print the resulting cipher as 4 x 16 byte strings
    //printf("ciphertext:\n");
    
    struct AES_ctx ctx;
    AES_init_ctx(&ctx, key);

    for (i = 0; i < 4; ++i)
    {
      AES_ECB_encrypt(&ctx, plain_text + (i * 16));
      phex(plain_text + (i * 16));
    }
    //printf("\n");
}


static int test_encrypt_ecb(void)
{
#if defined(AES256)
    uint8_t key[] = { 0x60, 0x3d, 0xeb, 0x10, 0x15, 0xca, 0x71, 0xbe, 0x2b, 0x73, 0xae, 0xf0, 0x85, 0x7d, 0x77, 0x81,
                      0x1f, 0x35, 0x2c, 0x07, 0x3b, 0x61, 0x08, 0xd7, 0x2d, 0x98, 0x10, 0xa3, 0x09, 0x14, 0xdf, 0xf4 };
    uint8_t out[] = { 0xf3, 0xee, 0xd1, 0xbd, 0xb5, 0xd2, 0xa0, 0x3c, 0x06, 0x4b, 0x5a, 0x7e, 0x3d, 0xb1, 0x81, 0xf8 };
#elif defined(AES192)
    uint8_t key[] = { 0x8e, 0x73, 0xb0, 0xf7, 0xda, 0x0e, 0x64, 0x52, 0xc8, 0x10, 0xf3, 0x2b, 0x80, 0x90, 0x79, 0xe5,
                      0x62, 0xf8, 0xea, 0xd2, 0x52, 0x2c, 0x6b, 0x7b };
    uint8_t out[] = { 0xbd, 0x33, 0x4f, 0x1d, 0x6e, 0x45, 0xf2, 0x5f, 0xf7, 0x12, 0xa2, 0x14, 0x57, 0x1f, 0xa5, 0xcc };
#elif defined(AES128)
    uint8_t key[] = { 0x2b, 0x7e, 0x15, 0x16, 0x28, 0xae, 0xd2, 0xa6, 0xab, 0xf7, 0x15, 0x88, 0x09, 0xcf, 0x4f, 0x3c };
    uint8_t out[] = { 0x3a, 0xd7, 0x7b, 0xb4, 0x0d, 0x7a, 0x36, 0x60, 0xa8, 0x9e, 0xca, 0xf3, 0x24, 0x66, 0xef, 0x97 };
#endif

    uint8_t in[]  = { 0x6b, 0xc1, 0xbe, 0xe2, 0x2e, 0x40, 0x9f, 0x96, 0xe9, 0x3d, 0x7e, 0x11, 0x73, 0x93, 0x17, 0x2a };
    struct AES_ctx ctx;

    AES_init_ctx(&ctx, key);
    AES_ECB_encrypt(&ctx, in);

    //printf("ECB encrypt: ");

    if (0 == memcmp((char*) out, (char*) in, 16)) {
        //printf("SUCCESS!\n");
	return(0);
    } else {
        //printf("FAILURE!\n");
	return(1);
    }
}

static int test_decrypt_cbc(void)
{

#if defined(AES256)
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
    struct AES_ctx ctx;
    
    AES_init_ctx(&ctx, key);
    AES_ECB_decrypt(&ctx, in);

    //printf("ECB decrypt: ");

    if (0 == memcmp((char*) out, (char*) in, 16)) {
        //printf("SUCCESS!\n");
	return(0);
    } else {
        //printf("FAILURE!\n");
	return(1);
    }
}
