dineshannayya/riscduino/verilog/dv/bfm/usb_device/core/usb1d_pa.v

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
//  CVS Log
//
//  $Id: usb1_pa.v,v 1.1.1.1 2002-09-19 12:07:13 rudi Exp $
//
//  $Date: 2002-09-19 12:07:13 $
//  $Revision: 1.1.1.1 $
//  $Author: rudi $
//  $Locker:  $
//  $State: Exp $
//
// Change History:
//               $Log: not supported by cvs2svn $
//
//
//
//
//
//

`include "usb1d_defines.v"

module usb1d_pa(	clk, rst,

		// UTMI TX I/F
		tx_data, tx_valid, tx_valid_last, tx_ready,
		tx_first,

		// Protocol Engine Interface
		send_token, token_pid_sel,
		send_data, data_pid_sel,

		// IDMA Interface
		tx_data_st, rd_next,

		ep_empty
		);

input		clk, rst;

// UTMI TX Interface
output	[7:0]	tx_data;
output		tx_valid;
output		tx_valid_last;
input		tx_ready;
output		tx_first;

// Protocol Engine Interface
input		send_token;
input	[1:0]	token_pid_sel;
input		send_data;
input	[1:0]	data_pid_sel;

// IDMA Interface
input	[7:0]	tx_data_st;
output		rd_next;

input		ep_empty;

///////////////////////////////////////////////////////////////////
//
// Local Wires and Registers
//

parameter	[3:0]	// synopsys enum state
		IDLE   = 4'b0001,
		DATA   = 4'b0010,
		CRC1   = 4'b0100,
		CRC2   = 4'b1000;

reg	[3:0]	/* synopsys enum state */ state, next_state;
// synopsys state_vector state

reg		last;
reg		rd_next;

reg	[7:0]	token_pid, data_pid;	// PIDs from selectors
reg	[7:0]	tx_data_d;
reg	[7:0]	tx_data_data;
reg		dsel;
reg		tx_valid_d;
reg		send_token_r;
reg	[7:0]	tx_spec_data;
reg		crc_sel1, crc_sel2;
reg		tx_first_r;
reg		send_data_r;
wire		crc16_clr;
reg	[15:0]	crc16;
wire	[15:0]	crc16_next;
wire	[15:0]	crc16_rev;
reg		crc16_add;
reg		send_data_r2;
reg		tx_valid_r;
reg		tx_valid_r1;

wire		zero_length;

///////////////////////////////////////////////////////////////////
//
// Misc Logic
//
reg		zero_length_r;
assign		zero_length = ep_empty;

always @(posedge clk or negedge rst)
	if(!rst)	zero_length_r <= #1 1'b0;
	else
	if(last)	zero_length_r <= #1 1'b0;
	else
	if(crc16_clr)	zero_length_r <= #1 zero_length;

always @(posedge clk)
	tx_valid_r1 <= #1 tx_valid;

always @(posedge clk)
	tx_valid_r <= #1 tx_valid_r1;

always @(posedge clk or negedge rst)
	if(!rst)	send_token_r <= #1 1'b0;
	else
	if(send_token)	send_token_r <= #1 1'b1;
	else
	if(tx_ready)	send_token_r <= #1 1'b0;

// PID Select
always @(token_pid_sel)
	case(token_pid_sel)		// synopsys full_case parallel_case
	   2'd0: token_pid = {  ~`USBF_T_PID_ACK,   `USBF_T_PID_ACK};
	   2'd1: token_pid = { ~`USBF_T_PID_NACK,  `USBF_T_PID_NACK};
	   2'd2: token_pid = {~`USBF_T_PID_STALL, `USBF_T_PID_STALL};
	   2'd3: token_pid = { ~`USBF_T_PID_NYET,  `USBF_T_PID_NYET};
	endcase

always @(data_pid_sel)
	case(data_pid_sel)		// synopsys full_case parallel_case
	   2'd0: data_pid = { ~`USBF_T_PID_DATA0, `USBF_T_PID_DATA0};
	   2'd1: data_pid = { ~`USBF_T_PID_DATA1, `USBF_T_PID_DATA1};
	   2'd2: data_pid = { ~`USBF_T_PID_DATA2, `USBF_T_PID_DATA2};
	   2'd3: data_pid = { ~`USBF_T_PID_MDATA, `USBF_T_PID_MDATA};
	endcase

// Data path Muxes

always @(send_token or send_token_r or token_pid or tx_data_data)
	if(send_token | send_token_r)	tx_data_d = token_pid;
	else				tx_data_d = tx_data_data;

always @(dsel or tx_data_st or tx_spec_data)
	if(dsel)	tx_data_data = tx_spec_data;
	else		tx_data_data = tx_data_st;

always @(crc_sel1 or crc_sel2 or data_pid or crc16_rev)
	if(!crc_sel1 & !crc_sel2)	tx_spec_data = data_pid;
	else
	if(crc_sel1)			tx_spec_data = crc16_rev[15:8];	// CRC 1
	else				tx_spec_data = crc16_rev[7:0];	// CRC 2

assign tx_data = tx_data_d;

// TX Valid assignment
assign tx_valid_last = send_token | last;
assign tx_valid = tx_valid_d;

always @(posedge clk)
	tx_first_r <= #1 send_token | send_data;

assign tx_first = (send_token | send_data) & ! tx_first_r;

// CRC Logic
always @(posedge clk)
	send_data_r <= #1 send_data;

always @(posedge clk)
	send_data_r2 <= #1 send_data_r;

assign crc16_clr = send_data & !send_data_r;

always @(posedge clk)
	crc16_add <= #1 !zero_length_r &
			((send_data_r & !send_data_r2) | (rd_next & !crc_sel1));

always @(posedge clk)
	if(crc16_clr)		crc16 <= #1 16'hffff;
	else
	if(crc16_add)		crc16 <= #1 crc16_next;

usb1d_crc16 u1(
	.crc_in(	crc16		),
	.din(	{tx_data_st[0], tx_data_st[1],
		tx_data_st[2], tx_data_st[3],
		tx_data_st[4], tx_data_st[5],
		tx_data_st[6], tx_data_st[7]}	),
	.crc_out(	crc16_next		) );

assign crc16_rev[15] = ~crc16[8];
assign crc16_rev[14] = ~crc16[9];
assign crc16_rev[13] = ~crc16[10];
assign crc16_rev[12] = ~crc16[11];
assign crc16_rev[11] = ~crc16[12];
assign crc16_rev[10] = ~crc16[13];
assign crc16_rev[9]  = ~crc16[14];
assign crc16_rev[8]  = ~crc16[15];
assign crc16_rev[7]  = ~crc16[0];
assign crc16_rev[6]  = ~crc16[1];
assign crc16_rev[5]  = ~crc16[2];
assign crc16_rev[4]  = ~crc16[3];
assign crc16_rev[3]  = ~crc16[4];
assign crc16_rev[2]  = ~crc16[5];
assign crc16_rev[1]  = ~crc16[6];
assign crc16_rev[0]  = ~crc16[7];

///////////////////////////////////////////////////////////////////
//
// Transmit/Encode state machine
//

always @(posedge clk or negedge rst)
	if(!rst)	state <= #1 IDLE;
	else		state <= #1 next_state;

always @(state or send_data or tx_ready or tx_valid_r or zero_length)
   begin
	next_state = state;	// Default don't change current state
	tx_valid_d = 1'b0;
	dsel = 1'b0;
	rd_next = 1'b0;
	last = 1'b0;
	crc_sel1 = 1'b0;
	crc_sel2 = 1'b0;
	case(state)		// synopsys full_case parallel_case
	   IDLE:
		   begin
			if(zero_length & send_data)
			   begin
				tx_valid_d = 1'b1;
				dsel = 1'b1;
				next_state = CRC1;
			   end
			else
			if(send_data)		// Send DATA packet
			   begin
				tx_valid_d = 1'b1;
				dsel = 1'b1;
				next_state = DATA;
			   end
		   end
	   DATA:
		   begin
			if(tx_ready & tx_valid_r)
				rd_next = 1'b1;

			tx_valid_d = 1'b1;
			if(!send_data & tx_ready & tx_valid_r)
			   begin
				dsel = 1'b1;
				crc_sel1 = 1'b1;
				next_state = CRC1;
			   end
		   end
	   CRC1:
		   begin
			dsel = 1'b1;
			tx_valid_d = 1'b1;
			if(tx_ready)
			   begin
				last = 1'b1;
				crc_sel2 = 1'b1;
				next_state = CRC2;
			   end
			else
			   begin
				tx_valid_d = 1'b1;
				crc_sel1 = 1'b1;
			   end

		   end
	   CRC2:
		   begin
			dsel = 1'b1;
			crc_sel2 = 1'b1;
			if(tx_ready)
			   begin
				next_state = IDLE;
			   end
			else
			   begin
				last = 1'b1;
			   end

		   end
	endcase
   end

endmodule
