dineshannayya/riscduino/verilog/rtl/uart2wb/src/uart2wb.sv

//////////////////////////////////////////////////////////////////////////////
// SPDX-FileCopyrightText: 2021 , Dinesh Annayya                          
// 
// Licensed under the Apache License, Version 2.0 (the "License");
// you may not use this file except in compliance with the License.
// You may obtain a copy of the License at
//
//      http://www.apache.org/licenses/LICENSE-2.0
//
// Unless required by applicable law or agreed to in writing, software
// distributed under the License is distributed on an "AS IS" BASIS,
// WITHOUT WARRANTIES OR CONDITIONS OF ANY KIND, either express or implied.
// See the License for the specific language governing permissions and
// limitations under the License.
// SPDX-License-Identifier: Apache-2.0
// SPDX-FileContributor: Created by Dinesh Annayya <dinesha@opencores.org>
//
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
module uart2wb (  
        input wire                  arst_n          , //  sync reset
        input wire                  app_clk         , //  sys clock    

	// configuration control
       input wire                  cfg_tx_enable    , // Enable Transmit Path
       input wire                  cfg_rx_enable    , // Enable Received Path
       input wire                  cfg_stop_bit     , // 0 -> 1 Start , 1 -> 2 Stop Bits
       input wire [1:0]            cfg_pri_mod      , // priority mode, 0 -> nop, 1 -> Even, 2 -> Odd
       input wire [11:0]	    cfg_baud_16x     , // 16x Baud clock generation

    // Master Port
       output   wire                wbm_cyc_o        ,  // strobe/request
       output   wire                wbm_stb_o        ,  // strobe/request
       output   wire [31:0]         wbm_adr_o        ,  // address
       output   wire                wbm_we_o         ,  // write
       output   wire [31:0]         wbm_dat_o        ,  // data output
       output   wire [3:0]          wbm_sel_o        ,  // byte enable
       input    wire [31:0]         wbm_dat_i        ,  // data input
       input    wire                wbm_ack_i        ,  // acknowlegement
       input    wire                wbm_err_i        ,  // error

       // Status information
       output   wire               frm_error        , // framing error
       output   wire       	    par_error        , // par error

       output   wire               baud_clk_16x     , // 16x Baud clock

       // Line Interface
       input    wire              rxd               , // uart rxd
       output   wire              txd                 // uart txd

     );






//-------------------------------------
//---------------------------------------
// Control Unit interface
// --------------------------------------

wire  [31:0]       reg_addr        ; // Register Address
wire  [31:0]       reg_wdata       ; // Register Wdata
wire               reg_req         ; // Register Request
wire               reg_wr          ; // 1 -> write; 0 -> read
wire               reg_ack         ; // Register Ack
wire   [31:0]      reg_rdata       ;
//--------------------------------------
// TXD Path
// -------------------------------------
wire              tx_data_avail    ; // Indicate valid TXD Data 
wire [7:0]        tx_data          ; // TXD Data to be transmited
wire              tx_rd            ; // Indicate TXD Data Been Read


//--------------------------------------
// RXD Path
// -------------------------------------
wire         rx_ready              ; // Indicate Ready to accept the Read Data
wire [7:0]  rx_data                ; // RXD Data 
wire        rx_wr                  ; // Valid RXD Data

wire        line_reset_n           ;

assign wbm_cyc_o  = wbm_stb_o;


// Async App clock to Uart clock handling

async_reg_bus #(.AW(32), .DW(32),.BEW(4))
          u_async_reg_bus (
    // Initiator declartion
          .in_clk                    (baud_clk_16x),
          .in_reset_n                (line_reset_n),
       // Reg Bus Master
          // outputs
          .in_reg_rdata               (reg_rdata),
          .in_reg_ack                 (reg_ack),
          .in_reg_timeout             (),

          // Inputs
          .in_reg_cs                  (reg_req),
          .in_reg_addr                (reg_addr),
          .in_reg_wdata               (reg_wdata),
          .in_reg_wr                  (reg_wr),
          .in_reg_be                  (4'hF), // No byte enable based support

    // Target Declaration
          .out_clk                    (app_clk),
          .out_reset_n                (arst_n),
      // Reg Bus Slave
          // output
          .out_reg_cs                 (wbm_stb_o),
          .out_reg_addr               (wbm_adr_o),
          .out_reg_wdata              (wbm_dat_o),
          .out_reg_wr                 (wbm_we_o),
          .out_reg_be                 (wbm_sel_o),

          // Inputs
          .out_reg_rdata              (wbm_dat_i),
          .out_reg_ack                (wbm_ack_i)
   );


uart2_core u_core (  
          .arst_n            (arst_n) ,
          .app_clk           (app_clk) ,

	// configuration control
          .cfg_tx_enable      (cfg_tx_enable) , 
          .cfg_rx_enable      (cfg_rx_enable) , 
          .cfg_stop_bit       (cfg_stop_bit)  , 
          .cfg_pri_mod        (cfg_pri_mod)   , 
	  .cfg_baud_16x       (cfg_baud_16x)  ,

    // TXD Information
          .tx_data_avail      (tx_data_avail) ,
          .tx_rd              (tx_rd)         ,
          .tx_data            (tx_data)       ,
         

    // RXD Information
          .rx_ready           (rx_ready)      ,
          .rx_wr              (rx_wr)         ,
          .rx_data            (rx_data)       ,

       // Status information
          .frm_error          (frm_error) ,
	  .par_error          (par_error) ,

	  .baud_clk_16x       (baud_clk_16x) ,
	  .line_reset_n       (line_reset_n),

       // Line Interface
          .rxd                (rxd) ,
          .txd                (txd) 

     );



uart_msg_handler u_msg (  
          .reset_n            (arst_n ) ,
          .sys_clk            (baud_clk_16x ) ,


    // UART-TX Information
          .tx_data_avail      (tx_data_avail) ,
          .tx_rd              (tx_rd) ,
          .tx_data            (tx_data) ,
         

    // UART-RX Information
          .rx_ready           (rx_ready) ,
          .rx_wr              (rx_wr) ,
          .rx_data            (rx_data) ,

      // Towards Control Unit
          .reg_addr          (reg_addr),
          .reg_wr            (reg_wr),
          .reg_wdata         (reg_wdata),
          .reg_req           (reg_req),
          .reg_ack           (reg_ack),
	  .reg_rdata         (reg_rdata) 

     );

endmodule
