dineshannayya/riscduino/verilog/rtl/clk_skew_adjust/src/clk_skew_adjust.v

module clk_skew_adjust (clk_in,
    clk_out,
    vccd1,
    vssd1,
    sel);
 input clk_in;
 output clk_out;
 input vccd1;
 input vssd1;
 input [3:0] sel;

 sky130_fd_sc_hd__clkdlybuf4s15_2 clkbuf_1 (.A(clk_in),
    .X(clk_d1),
    .VGND(vssd1),
    .VNB(vssd1),
    .VPB(vccd1),
    .VPWR(vccd1));
 sky130_fd_sc_hd__clkdlybuf4s15_2 clkbuf_10 (.A(clk_d9),
    .X(clk_d10),
    .VGND(vssd1),
    .VNB(vssd1),
    .VPB(vccd1),
    .VPWR(vccd1));
 sky130_fd_sc_hd__clkdlybuf4s15_2 clkbuf_11 (.A(clk_d10),
    .X(clk_d11),
    .VGND(vssd1),
    .VNB(vssd1),
    .VPB(vccd1),
    .VPWR(vccd1));
 sky130_fd_sc_hd__clkdlybuf4s15_2 clkbuf_12 (.A(clk_d11),
    .X(clk_d12),
    .VGND(vssd1),
    .VNB(vssd1),
    .VPB(vccd1),
    .VPWR(vccd1));
 sky130_fd_sc_hd__clkdlybuf4s15_2 clkbuf_13 (.A(clk_d12),
    .X(clk_d13),
    .VGND(vssd1),
    .VNB(vssd1),
    .VPB(vccd1),
    .VPWR(vccd1));
 sky130_fd_sc_hd__clkdlybuf4s15_2 clkbuf_14 (.A(clk_d13),
    .X(clk_d14),
    .VGND(vssd1),
    .VNB(vssd1),
    .VPB(vccd1),
    .VPWR(vccd1));
 sky130_fd_sc_hd__clkdlybuf4s15_2 clkbuf_15 (.A(clk_d14),
    .X(clk_d15),
    .VGND(vssd1),
    .VNB(vssd1),
    .VPB(vccd1),
    .VPWR(vccd1));
 sky130_fd_sc_hd__clkdlybuf4s15_2 clkbuf_2 (.A(clk_d1),
    .X(clk_d2),
    .VGND(vssd1),
    .VNB(vssd1),
    .VPB(vccd1),
    .VPWR(vccd1));
 sky130_fd_sc_hd__clkdlybuf4s15_2 clkbuf_3 (.A(clk_d2),
    .X(clk_d3),
    .VGND(vssd1),
    .VNB(vssd1),
    .VPB(vccd1),
    .VPWR(vccd1));
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
    .VNB(vssd1),
    .VPB(vccd1),
    .VPWR(vccd1));
 sky130_fd_sc_hd__decap_6 FILLER_31_180 (.VGND(vssd1),
    .VNB(vssd1),
    .VPB(vccd1),
    .VPWR(vccd1));
 sky130_fd_sc_hd__decap_3 FILLER_31_187 (.VGND(vssd1),
    .VNB(vssd1),
    .VPB(vccd1),
    .VPWR(vccd1));
endmodule
