dineshannayya/riscduino/verilog/dv/model/s25fl256s.sv

//////////////////////////////////////////////////////////////////////////////
// SPDX-FileCopyrightText: 2012 Spansion, LLC.
// 
// Licensed under the Apache License, Version 2.0 (the "License");
// you may not use this file except in compliance with the License.
// You may obtain a copy of the License at
//
//      http://www.apache.org/licenses/LICENSE-2.0
//
// Unless required by applicable law or agreed to in writing, software
// distributed under the License is distributed on an "AS IS" BASIS,
// WITHOUT WARRANTIES OR CONDITIONS OF ANY KIND, either express or implied.
// See the License for the specific language governing permissions and
// limitations under the License.
// SPDX-License-Identifier: Apache-2.0
// SPDX-FileContributor: Created by Dinesh Annayya <dinesha@opencores.org>
//
///////////////////////////////////////////////////////////////////////////////
//  File name : s25fl256s.v
///////////////////////////////////////////////////////////////////////////////
///////////////////////////////////////////////////////////////////////////////
//  Copyright (C) 2012 Spansion, LLC.
//
//  MODIFICATION HISTORY :
//
//  version: | author:     |  mod date:  | changes made:
//    V1.0      V.Mancev     19 Nov 09      Initial
//            R.Prokopovic
//    V1.1      V.Mancev     04 Mar 10    addr_cnt for second read in
//                                        high performance read continuous
//                                        mode can change its value only
//                                        when CSNeg = '0'
//    V1.2      V.Mancev     23 Mar 10    During read operations read_out
//                                        signal changes its value in
//                                        shorter interval
//    V1.3      V.Mancev     12 Apr 10    HOLD mode corrected
//                                        Condition for PP operation
//                                        corrected
//    V1.4      V.Mancev     20 May 10    SRWD bit assignment is corrected
//                                        Condition for WRR command in
//                                        write_cycle _decode section is
//                                        corrected
//                                        Blocking assignments for signals
//                                        WSTART and PSTART are replaced
//                                        with nonblocking assignments
//                                        Conditions in Page Program
//                                        section are fixed
//    V1.5      V.Mancev     25 May 10    Conditions in programming
//                                        sections are fixed
//                                        Timing control sections for
//                                        Program and Erase operation are
//                                        changed
//    V1.6      V.Mancev     03 June 10   bus_cycle_state section for
//                                        PGSP command is fixed
//    V1.7      V.Mancev     28 July 10   During the QUAD mode HOLD# input
//                                        is not monitored for its normal
//                                        function
//                                        write cycle decode section is
//                                        changed
//    V1.8     B.Colakovic   24 Aug 10    All redundant signals are removed
//                                        from BusCycle process
//    V1.9      V.Mancev     30 Sep 10    Latest datasheet aligned
//             B.Colakovic
//
//    V2.0      V.Mancev     05 Nov 10    Hybrid configuration added
//
//    V2.1      V.Mancev     12 Nov 10    QUAD Program operation during Erase
//                                        Suspend is added
//                                        Warning for Resume to Suspend time
//                                        is added
//                                        During Erase Suspend, after Program
//                                        operation is completed, WEL bit is
//                                        cleared
//                                        Implemetation of Software Reset is
//                                        Changed
//    V2.2      S.Petrovic   18 Apr 11    Corrected timing in always block
//                                        that generates rising_edge_CSNeg_ipd
//    V2.3      B.Colakovic  05 July 11   Latest datasheet aligned
//    V2.4      B.Colakovic  14 July 11   Optimization issue is fixed
//    V2.5      V.Mancev     19 July 11   Timing check issue is fixed
//    V2.6      V. Mancev    18 Nov 11    Time tHO is changed to 1 ns
//                                        (customer's request)
//                                        BRWR instruction is corrected
//    V2.7      S.Petrovic   28 Aug 12    QPP Instruction is allowed on
//                                        previously programmed page
//    V2.8      V. Mancev    13 Feb 13    Reverted restriction for QPP
//                                        on programmed page and
//                                        added clearing with sector erase
//    V2.9      S.Petrovic   13 Nov 28    Corrected FSM state transition
//                                        started on Power-Up and HW
//                                        Reset in StateGen process
//    V2.10     V. Mancev    13 Dec 20     Corrected DLP read
//    V2.11     M.Stojanovic 15 May 15    Ignored upper address bits for RD4
//    V2.12     M.Stojanovic 15 May 29    Ignored upper address bits for all
//                                        commands in QUAD mode
//    V2.13     M.Stojanovic 16 May 11    During QPP and QPP4 commands
//                                        the same page must not be
//                                        programmed more than once. However
//                                        do not generate P_ERR if this
//                                        occurs.
//    V2.14     M.Krneta     19 May 07    Updated according to the rev *P
//                                        (QPP and QPP4 commands changed,
//                                        ECCRD command added,
//                                        LOCK bit removed)
//    V2.15     B.Barac      20 Jan 24    Bug 49 fixed, issue with not assigning 
//                                        sector in commands P4E4 and P4E
//
///////////////////////////////////////////////////////////////////////////////
//  PART DESCRIPTION:
//
//  Library:    FLASH
//  Technology: FLASH MEMORY
//  Part:       S25FL256S
//
//  Description: 256 Megabit Serial Flash Memory
//
//////////////////////////////////////////////////////////////////////////////
//  Comments :
//      For correct simulation, simulator resolution should be set to 1 ps
//      A device ordering (trim) option determines whether a feature is enabled
//      or not, or provide relevant parameters:
//        -15th character in TimingModel determines if enhanced high
//         performance option is available
//            (0,2,3,R,A,B,C,D) EHPLC
//            (Y,Z,S,T,K,L)     Security EHPLC
//            (4,6,7,8,9,Q)     HPLC
//        -15th character in TimingModel determines if RESET# input
//         is available
//            (R,A,B,C,D,Q.6,7,K,L,S,T,M,N,U,V)  RESET# is available
//            (0,2,3,4,8,9,Y.Z.W,X)              RESET# is tied to the inactive
//                                               state,inside the package.
//        -16th character in TimingModel determines Sector and Page Size:
//            (0) Sector Size = 64 kB;  Page Size = 256 bytes
//                Hybrid Top/Bottom sector size architecture
//            (1) Sector Size = 256 kB; Page Size = 512 bytes
//                Uniform sector size architecture
//////////////////////////////////////////////////////////////////////////////
//  Known Bugs:
//
//////////////////////////////////////////////////////////////////////////////

//////////////////////////////////////////////////////////////////////////////
// MODULE DECLARATION                                                       //
//////////////////////////////////////////////////////////////////////////////
`timescale 1 ps/1 ps

module s25fl256s
    (
        // Data Inputs/Outputs
        SI     ,
        SO     ,
        // Controls
        SCK    ,
        CSNeg  ,
        RSTNeg ,
        WPNeg  ,
        HOLDNeg

);
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
