dineshannayya/riscduino/verilog/dv/model/is62wvs1288.v

`default_nettype none
/*
 *  SPDX-FileCopyrightText: 2022 <Dinesh Annayya>
 *
 *  Riscdunio 
 *
 *  Copyright (C) 2022  Dinesh Annayya <dinesha.opencore.org>
 *
 *  Permission to use, copy, modify, and/or distribute this software for any
 *  purpose with or without fee is hereby granted, provided that the above
 *  copyright notice and this permission notice appear in all copies.
 *
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
 *  SPDX-License-Identifier: ISC
 */

`timescale 1 ns / 1 ps

//
// Simple SPI Ram simulation model for 128Kx8 LOW VOLTAGE, FAST SERIAL SRAM
// (IS62/65WVS1288GALL)
//
// This model samples io input signals 1ns before the SPI clock edge and
// updates output signals 1ns after the SPI clock edge.
//
// Supported commands:
//    0x03, 0x02, 0x3B , 0x38, 0xFF, 0x05 , 0x01
//    Instruction   Hex     Description
//    READ          0x03    Read data from memory array beginning at selected address
//    WRITE         0x02    Write data to memory array beginning at selected address
//    ESDI          0x3B    Enter SDI mode
//    ESQI          0x38    Enter SQI mode
//    RSTDQI        0xFF    Reset SDI/SQI mode
//    RDMR          0x05    Read Mode Register
//    WRMR          0x01    Write Mode Register
//

module is62wvs1288 #(
	parameter mem_file_name = "firmware.hex"
)(
	input csb,
	input clk,
	inout io0, // MOSI
	inout io1, // MISO
	inout io2,
	inout io3
);
	localparam verbose = 0;
	localparam integer latency = 8;
	
	reg [7:0] buffer;
	reg [3:0] reset_count = 0;
	reg [3:0] reset_monitor = 0;
	integer bitcount = 0;
	integer bytecount = 0;
	integer dummycount = 0;

	reg [7:0] spi_cmd;
	reg [23:0] spi_addr;

	reg [7:0] spi_in;
	reg [7:0] spi_out;
	reg spi_io_vld;


	localparam [1:0] sspi     = 1;
	localparam [1:0] dspi     = 2;
	localparam [1:0] qspi     = 3;
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
