dineshannayya/riscduino/(commit log)

2021-06-06 Initial version of efabless caravel user project
    [macro.cfg, pin_order.cfg]
2021-06-06 syntacore added
    [pin_order.cfg]
2021-06-08 spi master added
    [pin_order.cfg]
2021-06-13 sdram added
    [pin_order.cfg]
2021-06-13 pin order update for sdram & syntacore
    [pin_order.cfg]
2021-06-14 Read me update with Soc Pin Map
2021-06-14 signoff added
    [final_summary_report.csv]
2021-06-17 spi rtl issue fix in clkgen
2021-06-18 first user project lvs clean database
    [final_summary_report.csv, macro_placement.cfg, pin_order.cfg]
2021-06-18 def,lef,gds,mag,spi,magled added
2021-06-20 floor planning cleanup
    [macro_placement.cfg, pin_order.cfg]
2021-06-21 uart integrated into SOC
    [pin_order.cfg]
2021-06-21 uart test case integration
2021-06-21 def,gds,lef addition
    [final_summary_report.csv, pin_order.cfg]
2021-06-24 script update
    [final_summary_report.csv, macro_placement.cfg, pin_order.cfg]
2021-06-25 database update
    [final_summary_report.csv, macro.cfg, macro_placement.cfg, pin_order.cfg]
2021-06-25 user project def,lef,gds added
    [final_summary_report.csv]
2021-06-27 backand cleanup
    [final_summary_report.csv, macro.cfg, pin_order.cfg]
2021-06-27 wb_host rtl and openlane setup added
    [final_summary_report.csv, pin_order.cfg]
2021-06-27 updated database
    [final_summary_report.csv]
2021-06-28 DRC clean user_project_wrapper
    [final_summary_report.csv, macro.cfg, pin_order.cfg]
2021-06-28 precheck cleanup
    [final_summary_report.csv]
2021-06-30 Clock Skew adjust network added + Inside SDRAM WB Stagging FF added
    [macro.cfg, pin_order.cfg]
2021-06-30 first version of pre-check clean database
    [final_summary_report.csv]
2021-07-05 Clean GateSim and RTL Sim + Updated SPI Master
    [final_summary_report.csv, macro.cfg, pin_order.cfg]
2021-07-07 Timing Closure related clean-up. Hold fix added at spi-master and clock delay adjusted inside the clock_skew module
    [final_summary_report.csv, macro_placement.cfg, pin_order.cfg]
2021-07-07 spi unused input pin io_in[1:0] removed
    [final_summary_report.csv, pin_order.cfg]
2021-07-07 sdram clock connectivity correction at u_skew hookup
    [final_summary_report.csv]
2021-07-08 full chip sta clean-up: cpu,spi,rtc clock generation moved from glbl_cfg to wb_host
    [final_summary_report.csv, pin_order.cfg]
2021-07-10 sta clean up, global clock buf and reset buf added
    [final_summary_report.csv, macro.cfg, pin_order.cfg]
2021-07-11 clk_skew power hook fix
    [final_summary_report.csv, macro.cfg]
2021-07-12 Power Ring is now 8 + Power Mesh is 2 (vccd1 & vssd1)
    [final_summary_report.csv, pin_order.cfg]
2021-07-14 SPI Preftech logic added
    [final_summary_report.csv]
2021-07-15 syntacore timing optimization, timing stage added at scr1_pipe_mrpf
    [final_summary_report.csv]
2021-07-24 syntacore rtl changes to improve timing closure from 25Mhz to 50Mhz
    [final_summary_report.csv, pin_order.cfg]
2021-07-26 syntacore timing fix
    [final_summary_report.csv]
2021-07-27 spi master with qddr mode support added
    [final_summary_report.csv]
2021-07-28 i2cm integrated and share same uart io
    [final_summary_report.csv, macro.cfg, pin_order.cfg]
2021-07-28 YiFive Block Diagram Updated, Added I2C Master
2021-07-28 README updated with i2c info
2021-08-01 usb1 host is integrated
    [final_summary_report.csv, macro.cfg, pin_order.cfg]
2021-08-01 SPDX Non compliant text fix
    [i2c_slave_model.v, i2cm_defines.v, mt48lc8m8a2.v, s25fl256s.sv]
2021-08-09 antenna fix
    [final_summary_report.csv]
2021-08-10 synthesis with latest yosys with $ netname avoidance fix
    [final_summary_report.csv]
2021-08-19 Riscv Unalign access fix and sdr ctrl 8 bit address mode fix
    [final_summary_report.csv]
2021-08-23 timer_irq connectivity bug fix
2021-09-29 first version of riscduino with sdram removed, pinmux and sar_adc added
    [macro.cfg, pin_order.cfg]
2021-10-01 test bench clean-up
    [final_summary_report.csv, pin_order.cfg]
2021-10-03 drc clean project ver1.0
    [final_summary_report.csv, macro.cfg, pin_order.cfg]
2021-10-05 caravel update
    [final_summary_report.csv, pin_order.cfg]
2021-10-13 Basic Verification and Physical design cleanup
    [final_summary_report.csv, macro.cfg, pin_order.cfg]
2021-10-26 directory clean up
    [pin_order.cfg]
2021-11-05 sram blockage for magic drc fix
    [final_summary_report.csv, pin_order.cfg]
2021-11-11 Adding clock skew inside the subIO + Precheck cleanup
    [final_summary_report.csv, macro.cfg, pin_order.cfg]
2021-11-13 typical timing closed tape-in database
    [final_summary_report.csv, pin_order.cfg]
2021-11-14 wbhost reset bug fix and clocking cleanup
    [final_summary_report.csv]
2021-11-15 clk_ctl bug fix in wb_host
    [final_summary_report.csv, pin_order.cfg]
2021-11-15 wb_host regenerated
    [final_summary_report.csv]
2021-11-16 IP area optimization
    [final_summary_report.csv, pin_order.cfg]
2021-11-16 syntacore ip area reduction
    [final_summary_report.csv, pin_order.cfg]
2021-11-16 wb host output timing fix
    [final_summary_report.csv, pin_order.cfg]
2021-11-23 Timing clean-up + Signature Register Added in PinMux
    [final_summary_report.csv]
2021-12-07 area clean up
    [final_summary_report.csv, macro.cfg, pin_order.cfg]
2021-12-14 timing clean, syntacore gds link fix, 8KB SRAM added
    [final_summary_report.csv, macro.cfg, pin_order.cfg]
2021-12-14 pdn drc fix
    [final_summary_report.csv]
2021-12-15 metal denisty fix for met5
    [final_summary_report.csv, macro.cfg]
2021-12-15 met5 density fix
    [final_summary_report.csv, macro.cfg]
2021-12-21 MPW-4 submission with 8KB WishBone and 4KB TCM Memory
    [final_summary_report.csv, macro.cfg, pin_order.cfg]
2021-12-25 uart master interface added
    [final_summary_report.csv, macro.cfg, pin_order.cfg]
2022-01-01 soft reset added uses la[0] pin
    [final_summary_report.csv]
2022-01-06 tcm memory access bug fix and riscv regression update
    [final_summary_report.csv]
2022-01-09 Riscv Regression and Interrupt cleanup
    [final_summary_report.csv]
2022-01-14 moved riscv core fom syntacore to yifive/ycr1
    [final_summary_report.csv, pin_order.cfg]
2022-01-16 qspim update
    [final_summary_report.csv, pin_order.cfg]
2022-02-04 icache and dcache integration
    [final_summary_report.csv, macro.cfg, pin_order.cfg]
2022-02-05 precheck cleanup for power verilog
    [final_summary_report.csv]
2022-02-08 spisram support added in qspim
    [final_summary_report.csv, pin_order.cfg]
2022-02-09 Timing clean up and dcache bug fix
    [final_summary_report.csv, macro.cfg]
2022-02-15 imem burst access support added in riscv core
    [final_summary_report.csv]
2022-02-18 replaced sram with dffram
    [final_summary_report.csv, macro.cfg, pin_order.cfg]
2022-02-20 qspim bug fix, wbs clock gen update
    [final_summary_report.csv]
2022-02-25 spi flash file added
2022-03-08 wishbone cross-bar + sspi bug fix and test case clean up
    [final_summary_report.csv, macro.cfg, pin_order.cfg]
2022-03-11 usb bug fix
    [final_summary_report.csv]
2022-03-17 caravel address map fix 0x300F_FFFF
    [pin_order.cfg]
2022-03-18 caravel address range fix + test bench update for MPW5
    [final_summary_report.csv, macro.cfg]
2022-04-08 Uart increased to 2 and sspi cs# to 4
    [final_summary_report.csv, pin_order.cfg]
2022-06-04 mpw6 openlane setup
    [macro.cfg, macro_placement.cfg, pin_order.cfg]
2022-06-13 icache and dcache bypass option added
    [pin_order.cfg]
2022-06-16 icache and dcache bypass added
    [pin_order.cfg]
2022-06-24 first arduino based test cased added
2022-06-26 mpw-6 pdn fix and precheck xor fix
    [final_summary_report.csv]
2022-07-08 arduino test case integration
2022-07-20 spi isp option added
    [final_summary_report.csv, macro.cfg, pin_order.cfg]
2022-07-28 arduino_arrays test added
2022-07-29 arduino_switchCase2 test case added
2022-07-29 arduino_character_analysis test added
