dineshannayya/riscduino/(notices)

Notices in the files:
verilog/dv/user_pwm/user_pwm_tb.v:
SPDX-FileContributor: Modified by Dinesh Annayya <dinesha@opencores.org>
